projectsatlab/SmartNODE503/README.md

# SmartezNODE503
Smart ezNODE 503 hardware and software platform.

Hardware design assembly into 503 electric plant box based on ESP8266-012F WIFI module. 

Software architecture designed to interface TINKER MODE IoT devices platform.

Coming soon...
