projectsatlab/SmartNODE503/Smart ezNODE 503 TINKER MODE integration.pdf

## Smart ezNODE 503 TINKER MODE integration

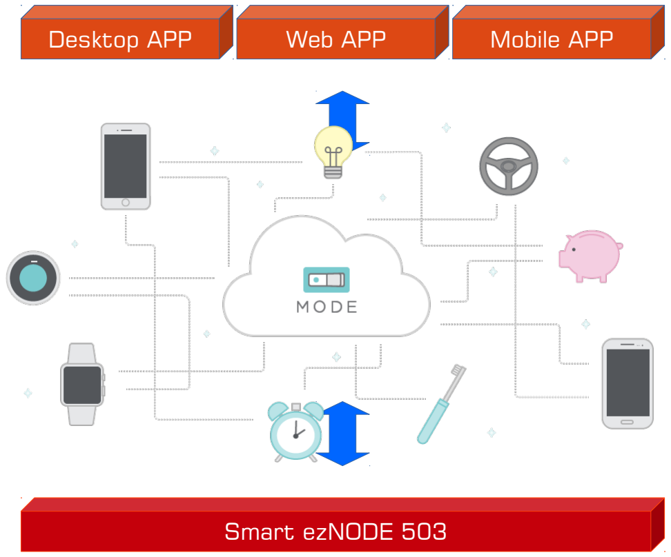
[picture p1: figure]
Smart ezNODE 503; Desktop APP; Web APP; Mobile APP

### www.tinkermode.com

Platform interface 100% open REST API. Code in any language.

WebSocket endpoint:
Allow a user to listen to events;
Allow a device to listen to command.

Android and IOS applications SDK.
