projectsatlab/SmartNODE503/Smart ezNODE 503 M1 (core) schema.pdf

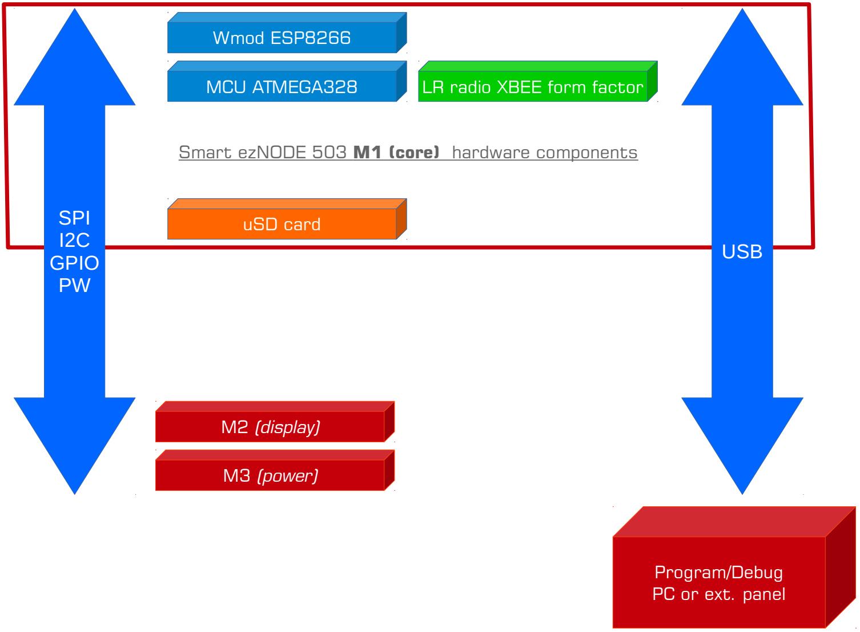
[picture p2: figure]
Program/Debug PC or ext. panel; MCU ATMEGA328; Wmod ESP8266; M2 (display); M3 (power); SPI I2C GPIO PW; uSD card; LR radio XBEE form factor; USB

Smart ezNODE 503 M1 (core) hardware components

## Smart ezNODE 503 M1 (core) schema
