projectsatlab/SmartNODE503/Hardware/Eagle files/20161213_1114_top_gold_with_mask_with_silk.png

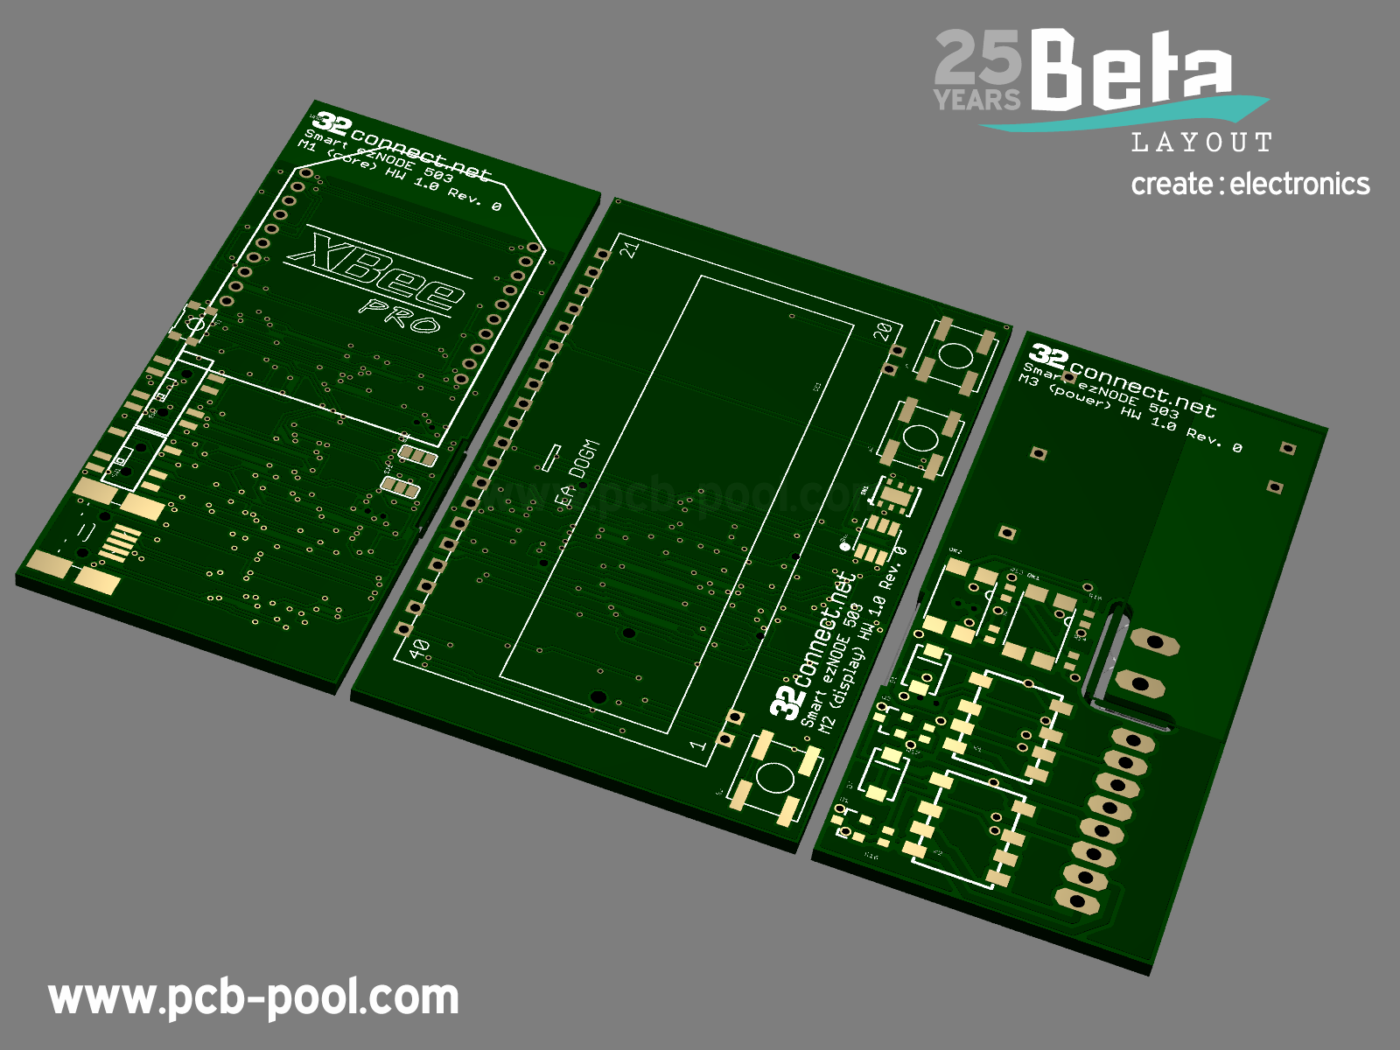
Hardware/Eagle files/20161213_1114_top_gold_with_mask_with_silk.png
