projectsatlab/SmartNODE503/Smart ezNODE 503 architecture schema.pdf

## Project architecture schema

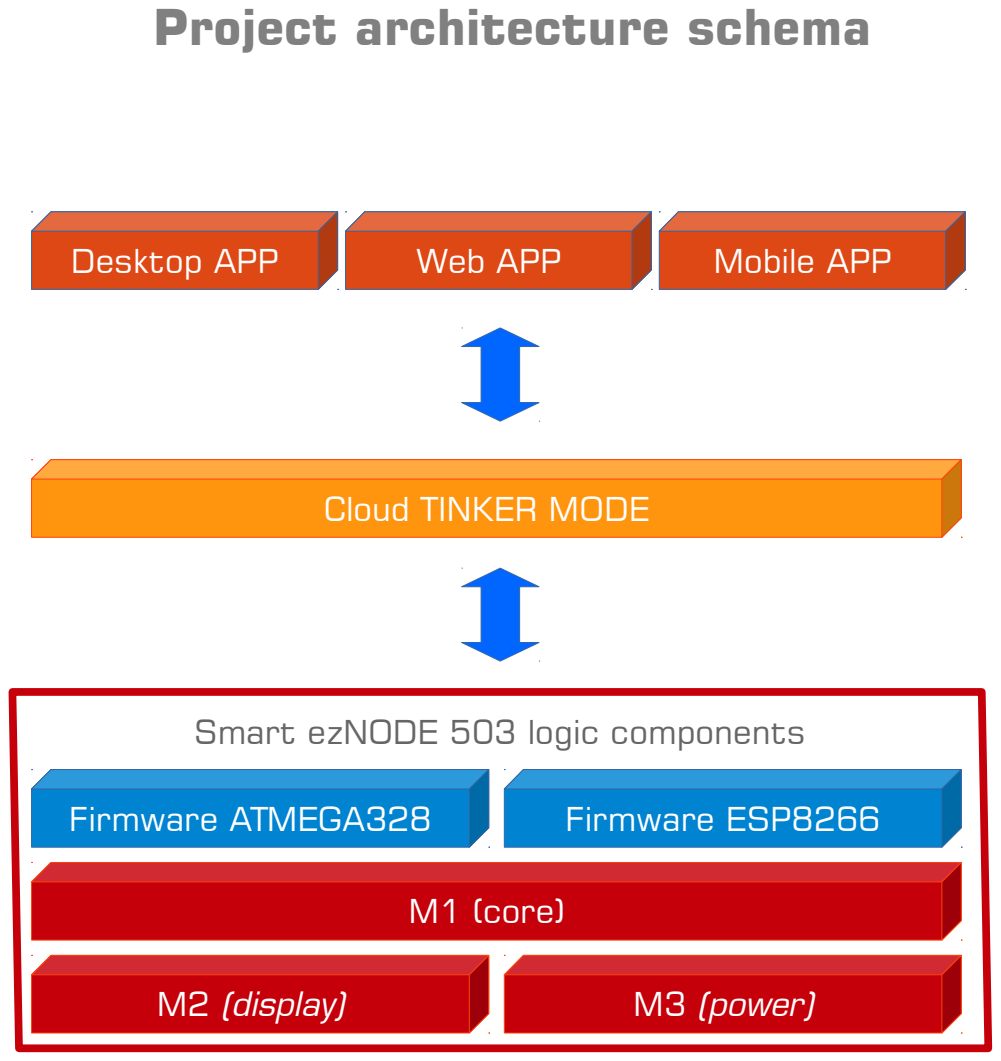
[picture p5: page 1]
M1 (core); Firmware ATMEGA328; Firmware ESP8266; Desktop APP; Web APP; Mobile APP; M2 (display); M3 (power)

Cloud TINKER MODE

Smart ezNODE 503 logic components
