projectsatlab/SmartNODE503/Hardware/Eagle files/Smart ezNODE 503 M1.sch.pdf

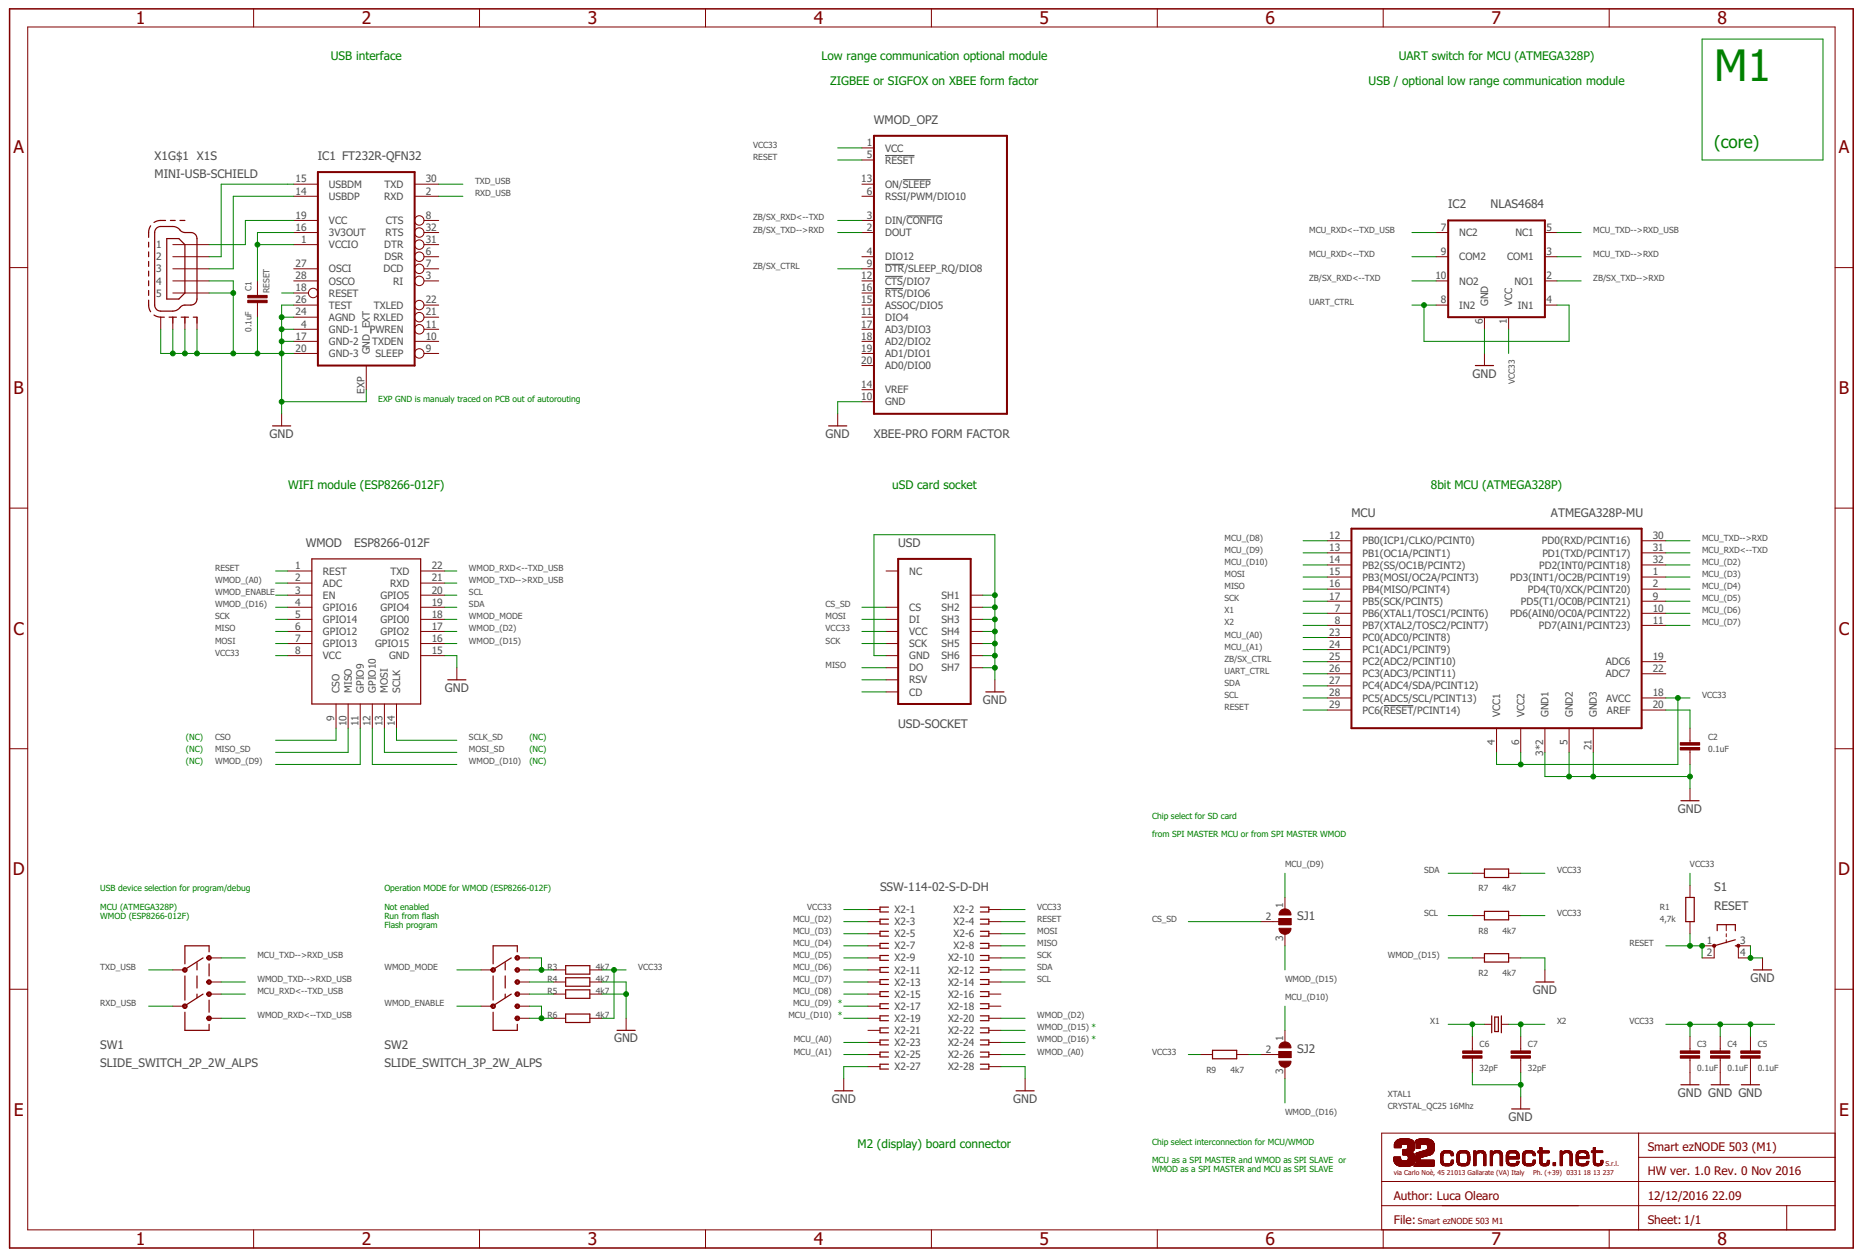
[picture p6: page 1]

USB / optional low range communication module

EXP GND is manualy traced on PCB out of autorouting

Chip select for SD card

from SPI MASTER MCU or from SPI MASTER WMOD

Chip select interconnection for MCU/WMOD MCU as a SPI MASTER and WMOD as SPI SLAVE or WMOD as a SPI MASTER and MCU as SPI SLAVE

HW ver. 1.0 Rev. 0 Nov 2016
