projectsatlab/SmartNODE503/Hardware/Eagle files/Smart ezNODE 503 guide lines.sch.pdf

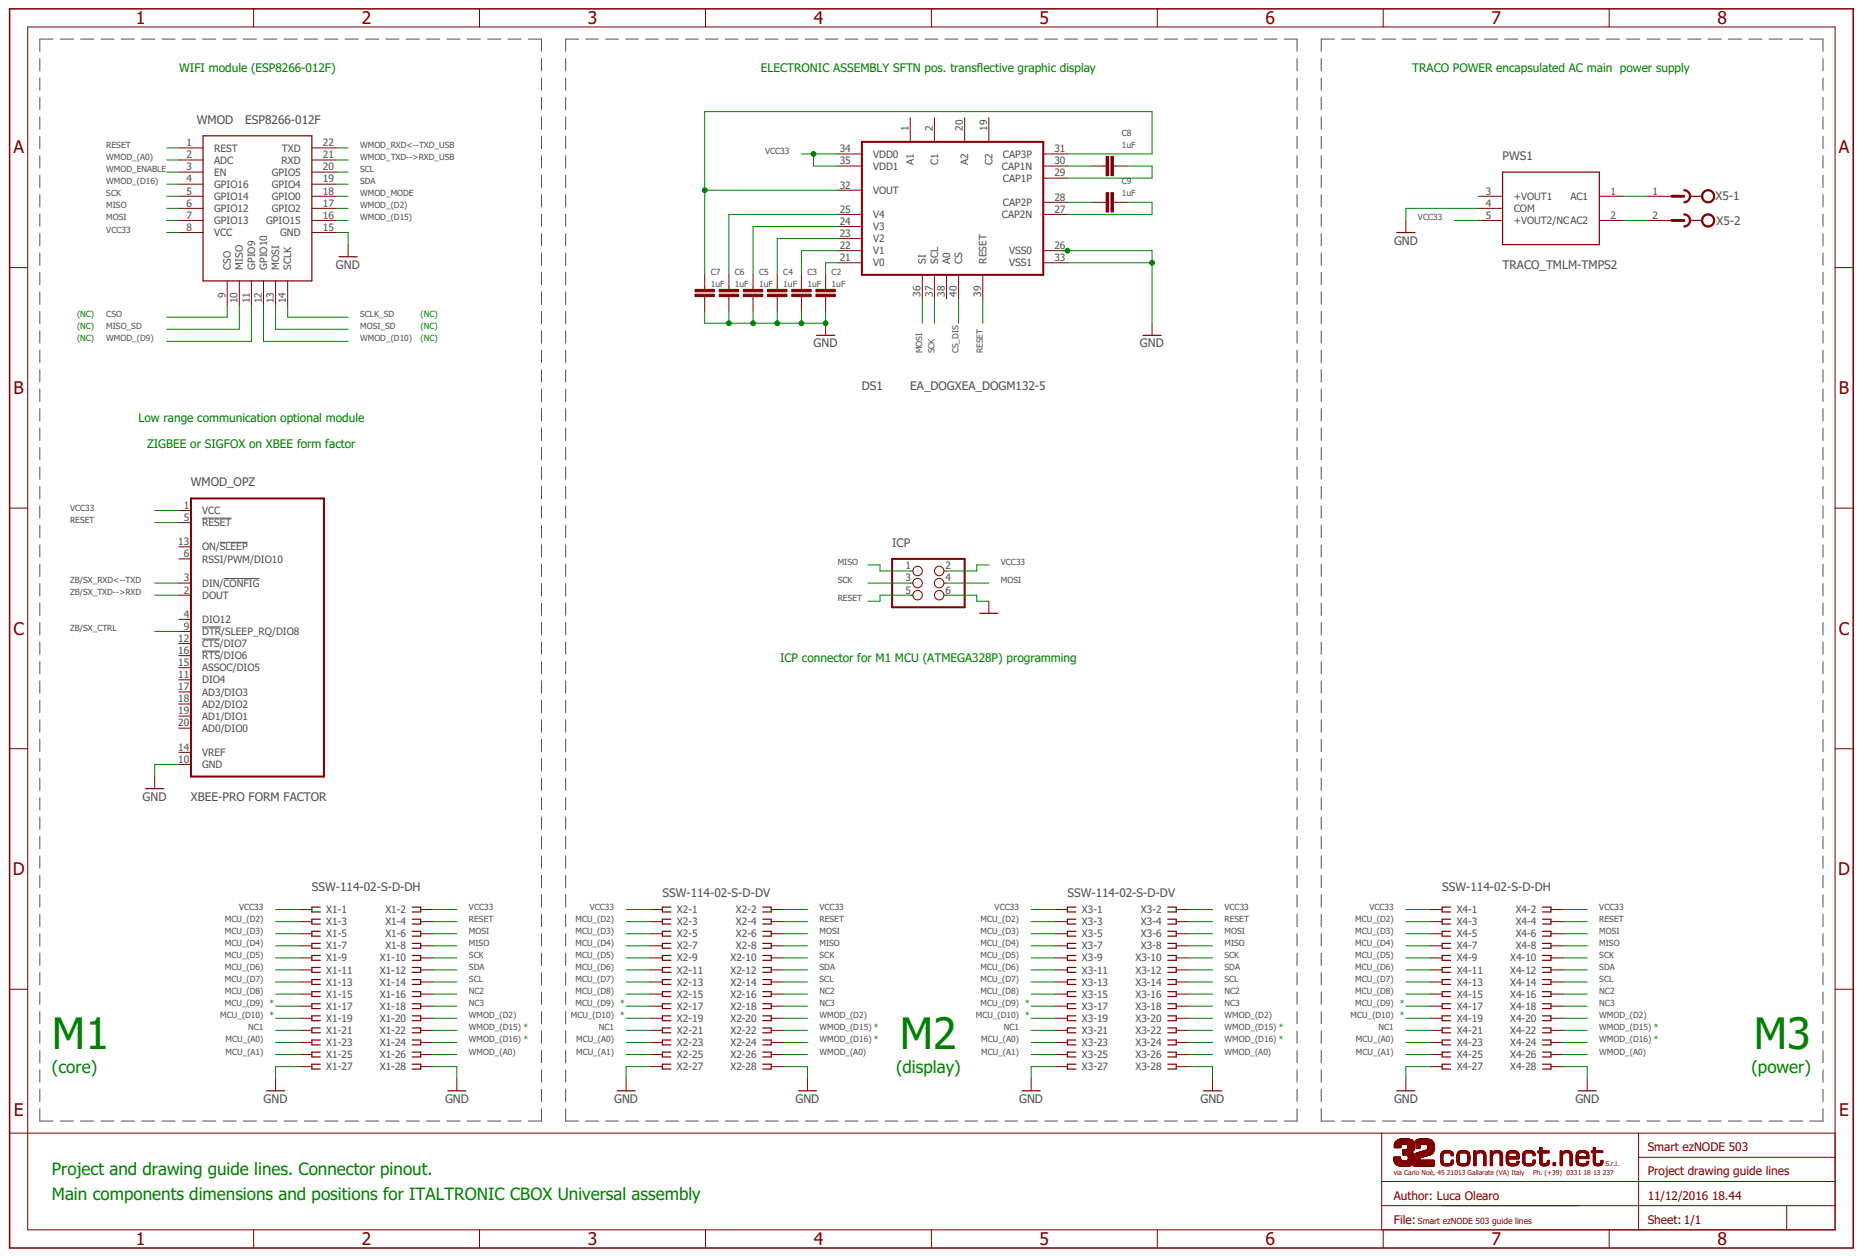
[picture p7: page 1]

Low range communication optional module ZIGBEE or SIGFOX on XBEE form factor

ICP connector for M1 MCU (ATMEGA328P) programming

Project and drawing guide lines. Connector pinout. Main components dimensions and positions for ITALTRONIC CBOX Universal assembly

Project drawing guide lines 11/12/2016 18.44

File: Smart ezNODE 503 guide lines
