projectsatlab/SmartNODE503/Hardware/Eagle files/Smart ezNODE 503 M3.sch.pdf

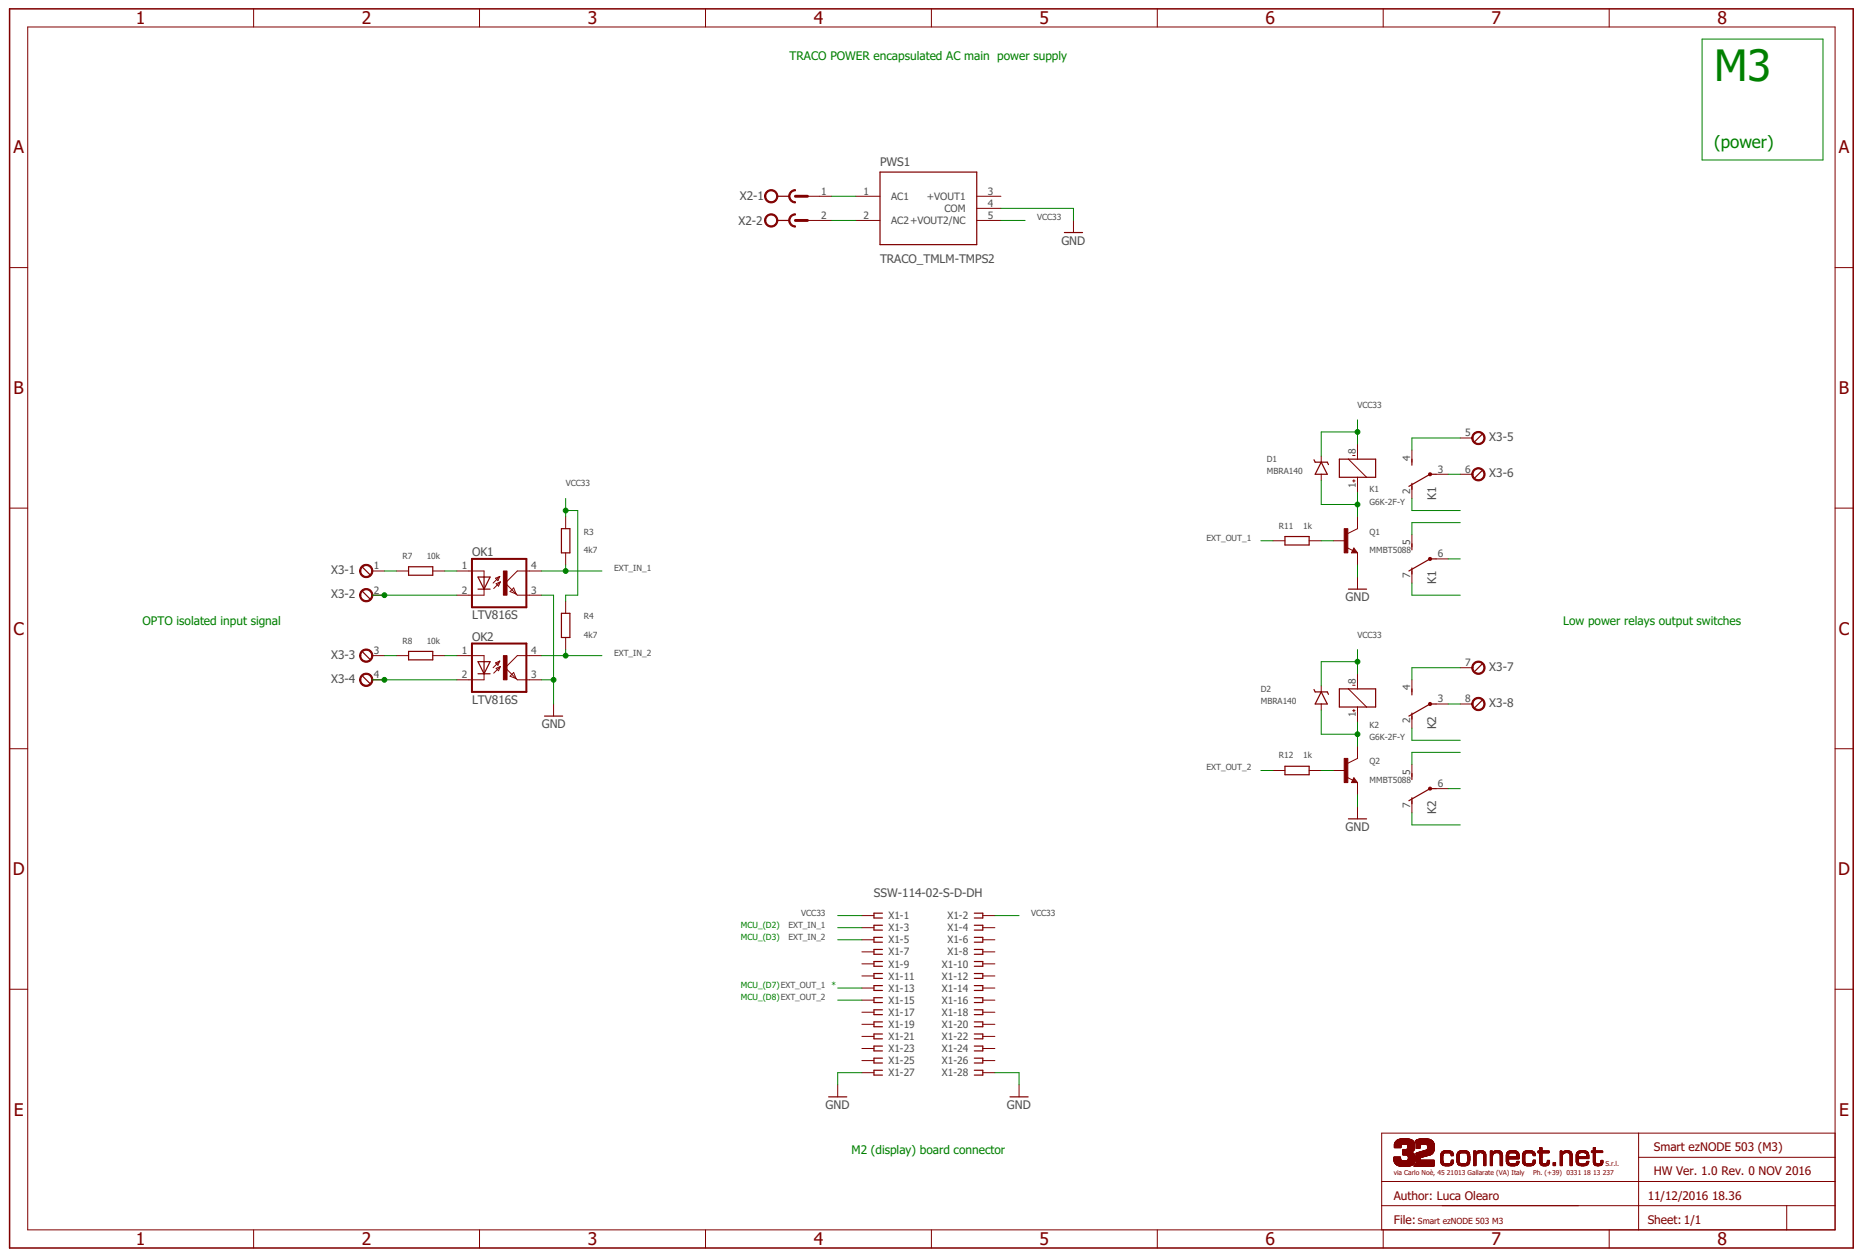
[picture p8: page 1]

TRACO POWER encapsulated AC main power supply

HW Ver. 1.0 Rev. 0 NOV 2016
