projectsatlab/SmartNODE503/Hardware/Eagle files/Smart ezNODE 503 M2.sch.pdf

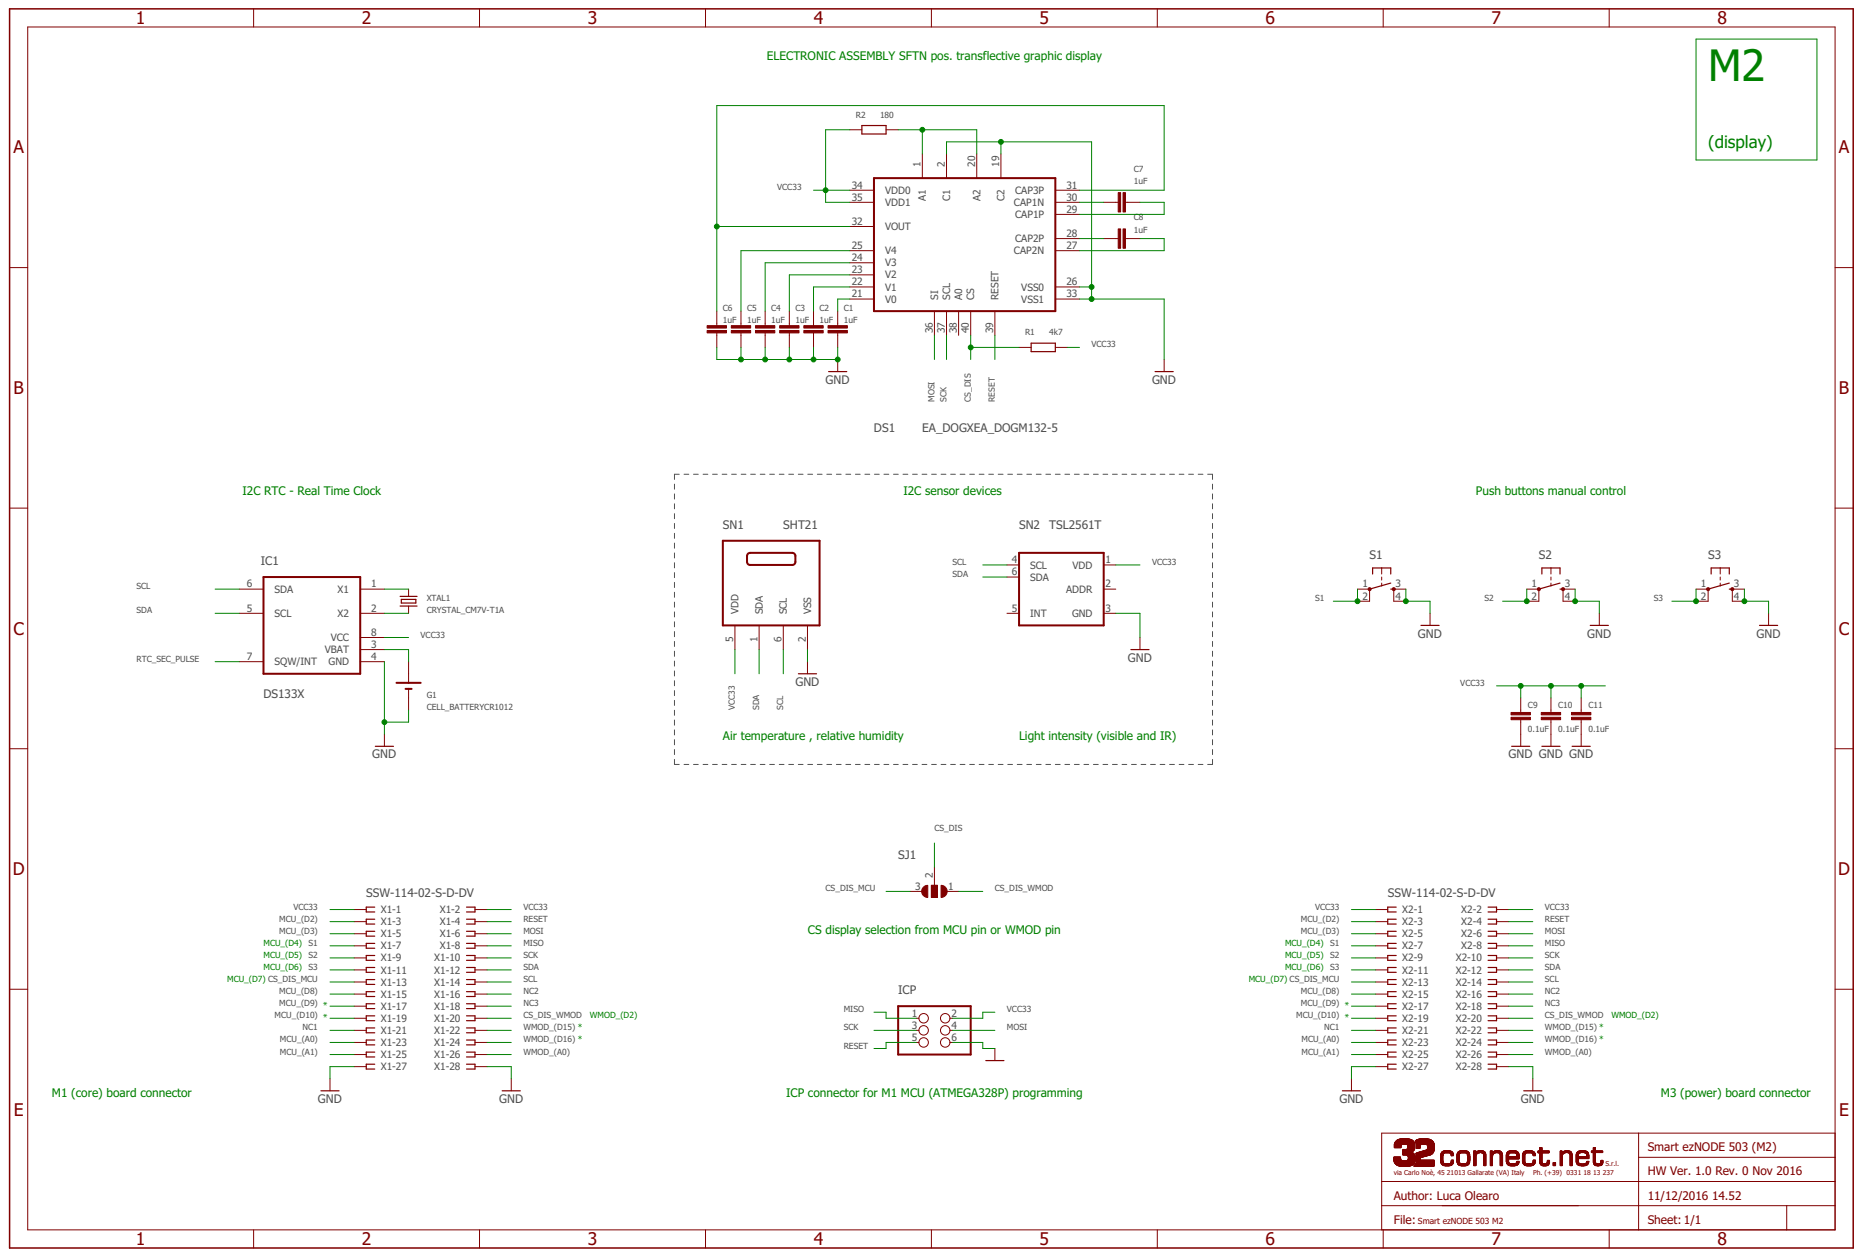
[picture p9: page 1]

ELECTRONIC ASSEMBLY SFTN pos. transflective graphic display

I2C RTC - Real Time Clock

Push buttons manual control

CS display selection from MCU pin or WMOD pin

HW Ver. 1.0 Rev. 0 Nov 2016
