projectsatlab/SmartNODE503/Hardware/Eagle files/BS584d7875344ef_Smart_ezNODE_503_M1-M2-M3_PCB_assembly_20161213121305.pdf

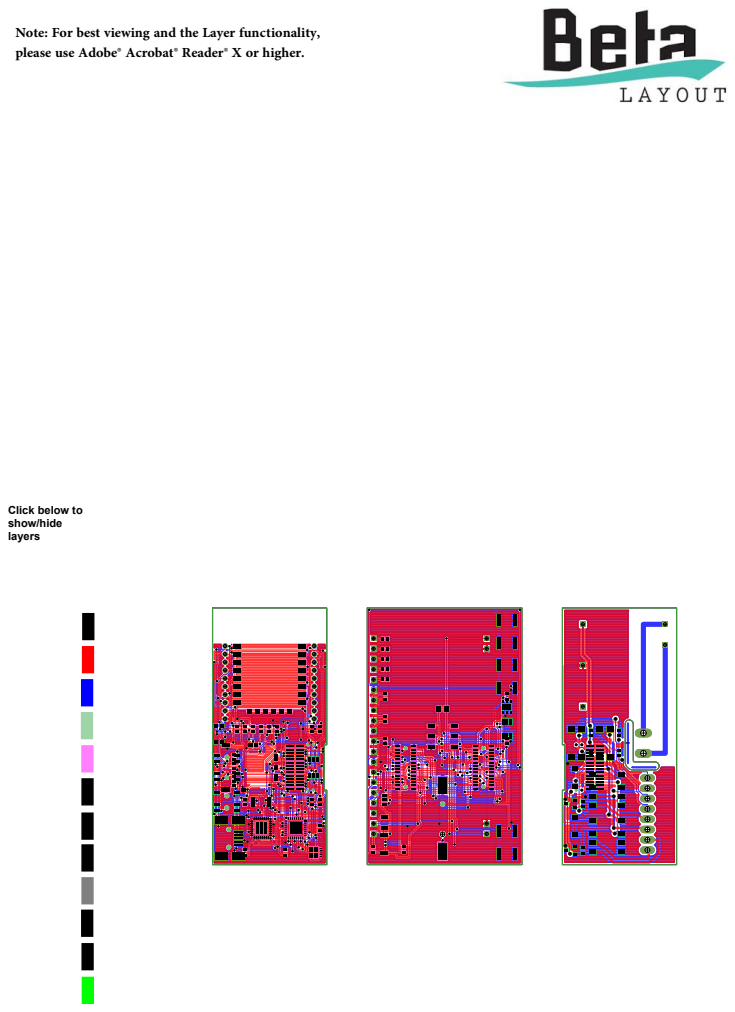
[picture p10: page 1]

Note: For best viewing and the Layer functionality,
please use Adobe® Acrobat® Reader® X or higher.
