projectsatlab/SmartNODE503/Hardware/Eagle files/Smart ezNODE 503 M1-M2-M3 PCB assembly.brd.pdf

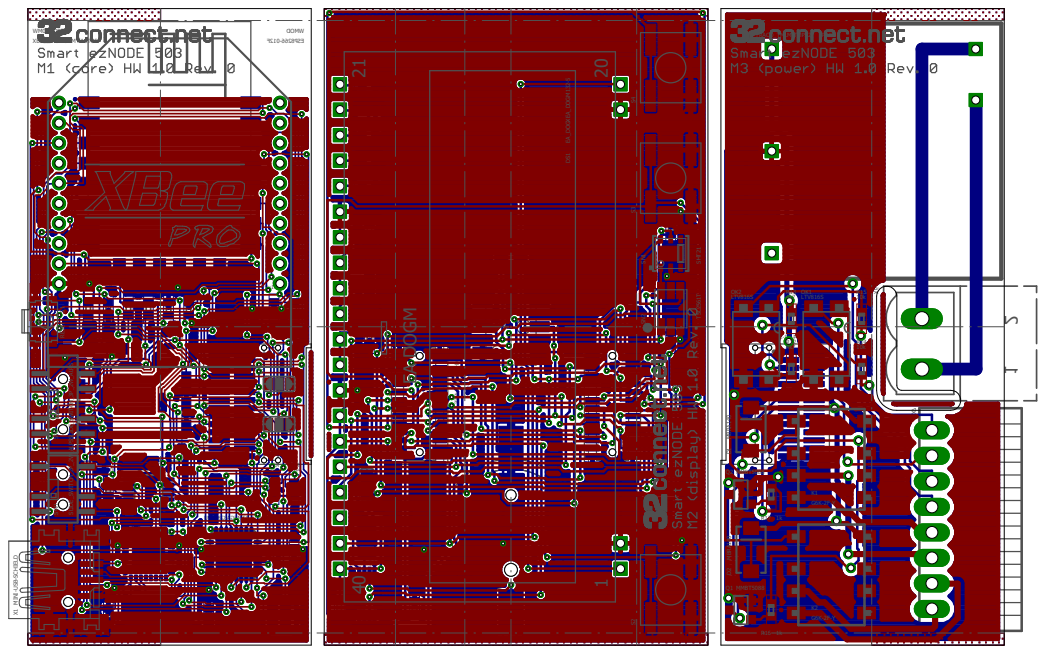
[picture p11: page 1]

Fu1. 0 F210- 6628PSE 23NF Q- R232TF UM- P823AGE MTA 4864SAL N 7k4 7k4 7k4 7k4 zh M61 52CQ_LATSYRC k7, 4 Fu1. 0 Fu1. 0 Fu1. 0 Fu1. 0 TEKCOS- DSU 7k4 7k4 7k4 HD- D- S- 20- 411- WSS7k432pF 32pF Fu1 Fu1 Fu1 Fu1 Fu1 Fu1 Fu1 Fu1 2101RCYRETTAB_LLEC CRYSTAL_CM7V-T1A SSW-114-02-S-D-DV DS133X SSW-114-02-S-D-DV 7k4 081 Fu1. 0 Fu1. 0 Fu1. 0 HD- D- S- 20- 411- WSS 1C 1CI UC M 2CI 6R 3R 5R 4R 1LATX 1R 2C 3C 4C 5C DSU 2R 8R 7R 2X 9RC6 C7 8C9C 01C 11C 21C 31C 41C 51C 1G XTAL2 X3 IC3 X4 ICP 01R SJ3 11R 61C 71C 81C 5X X6 X7 DOMW 2 1 1 2021 40 EA DOGM X1 SW1 SW2 WMOD_OPZS1 SJ1 SJ2 DS1 S2 S3 S4 SN1 SN2 OK2 OK1 R12 R13 R14 R15 K1 D1 Q1 R16 K2 D2 Q2 R17 PWS1 MINI-USB-SCHIELD SLIDE_SWITCH_2P_2W_ALPS LIDE_SWITCH_3P_2W_ALPS XBEE-PRO FORM FACTOR RESET EA_DOGXEA_DOGM132-5 SHT21 TSL2561TLTV816S LTV816S 4k7 4k7 10k 10k G6K-2F-Y MBRA140 MMBT5088 1k G6K-2F-Y MBRA140 MMBT5088 1k TRACO_TMLM-TMPS2
