projectsatlab/SmartNODE503/Hardware/Eagle files/Smart ezNODE 503 guide lines.brd.pdf

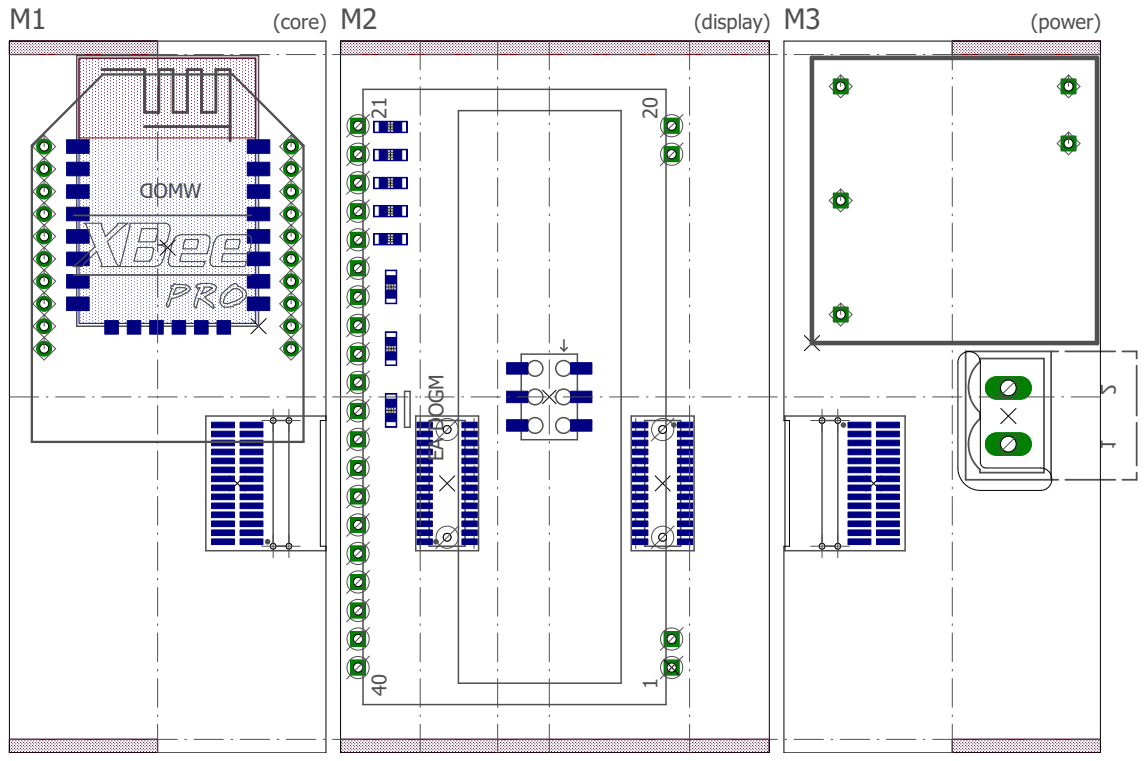
[picture p12: page 1]
