projectsatlab/SmartNODE503/Hardware/Techinical documents/ITALTRONIC cbox (1).pdf

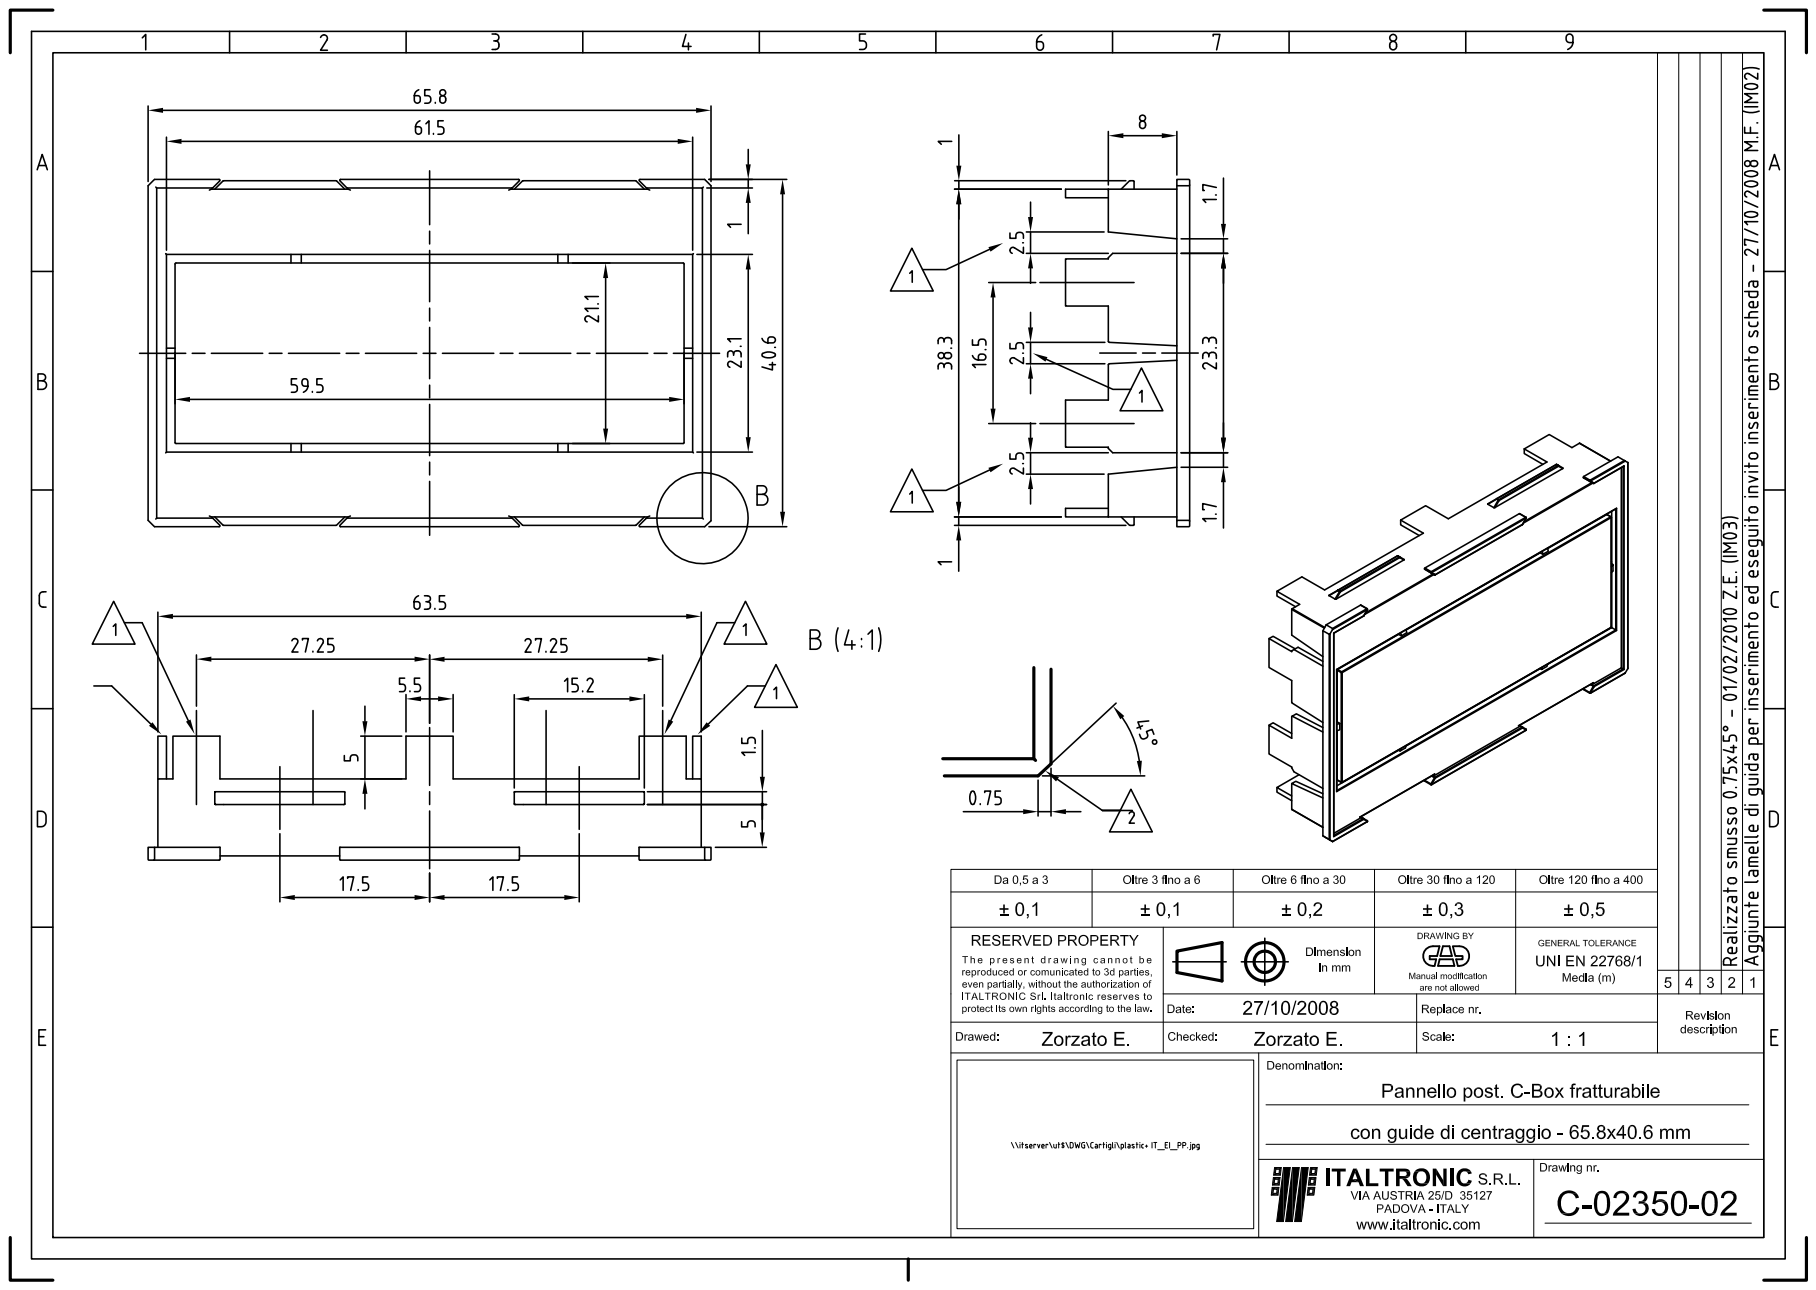
[picture p13: page 1]
