projectsatlab/SmartNODE503/Hardware/Eagle files/Smart ezNODE 503 M3.brd

## EAGLE design Hardware/Eagle files/Smart ezNODE 503 M3.brd (2016-12-13)

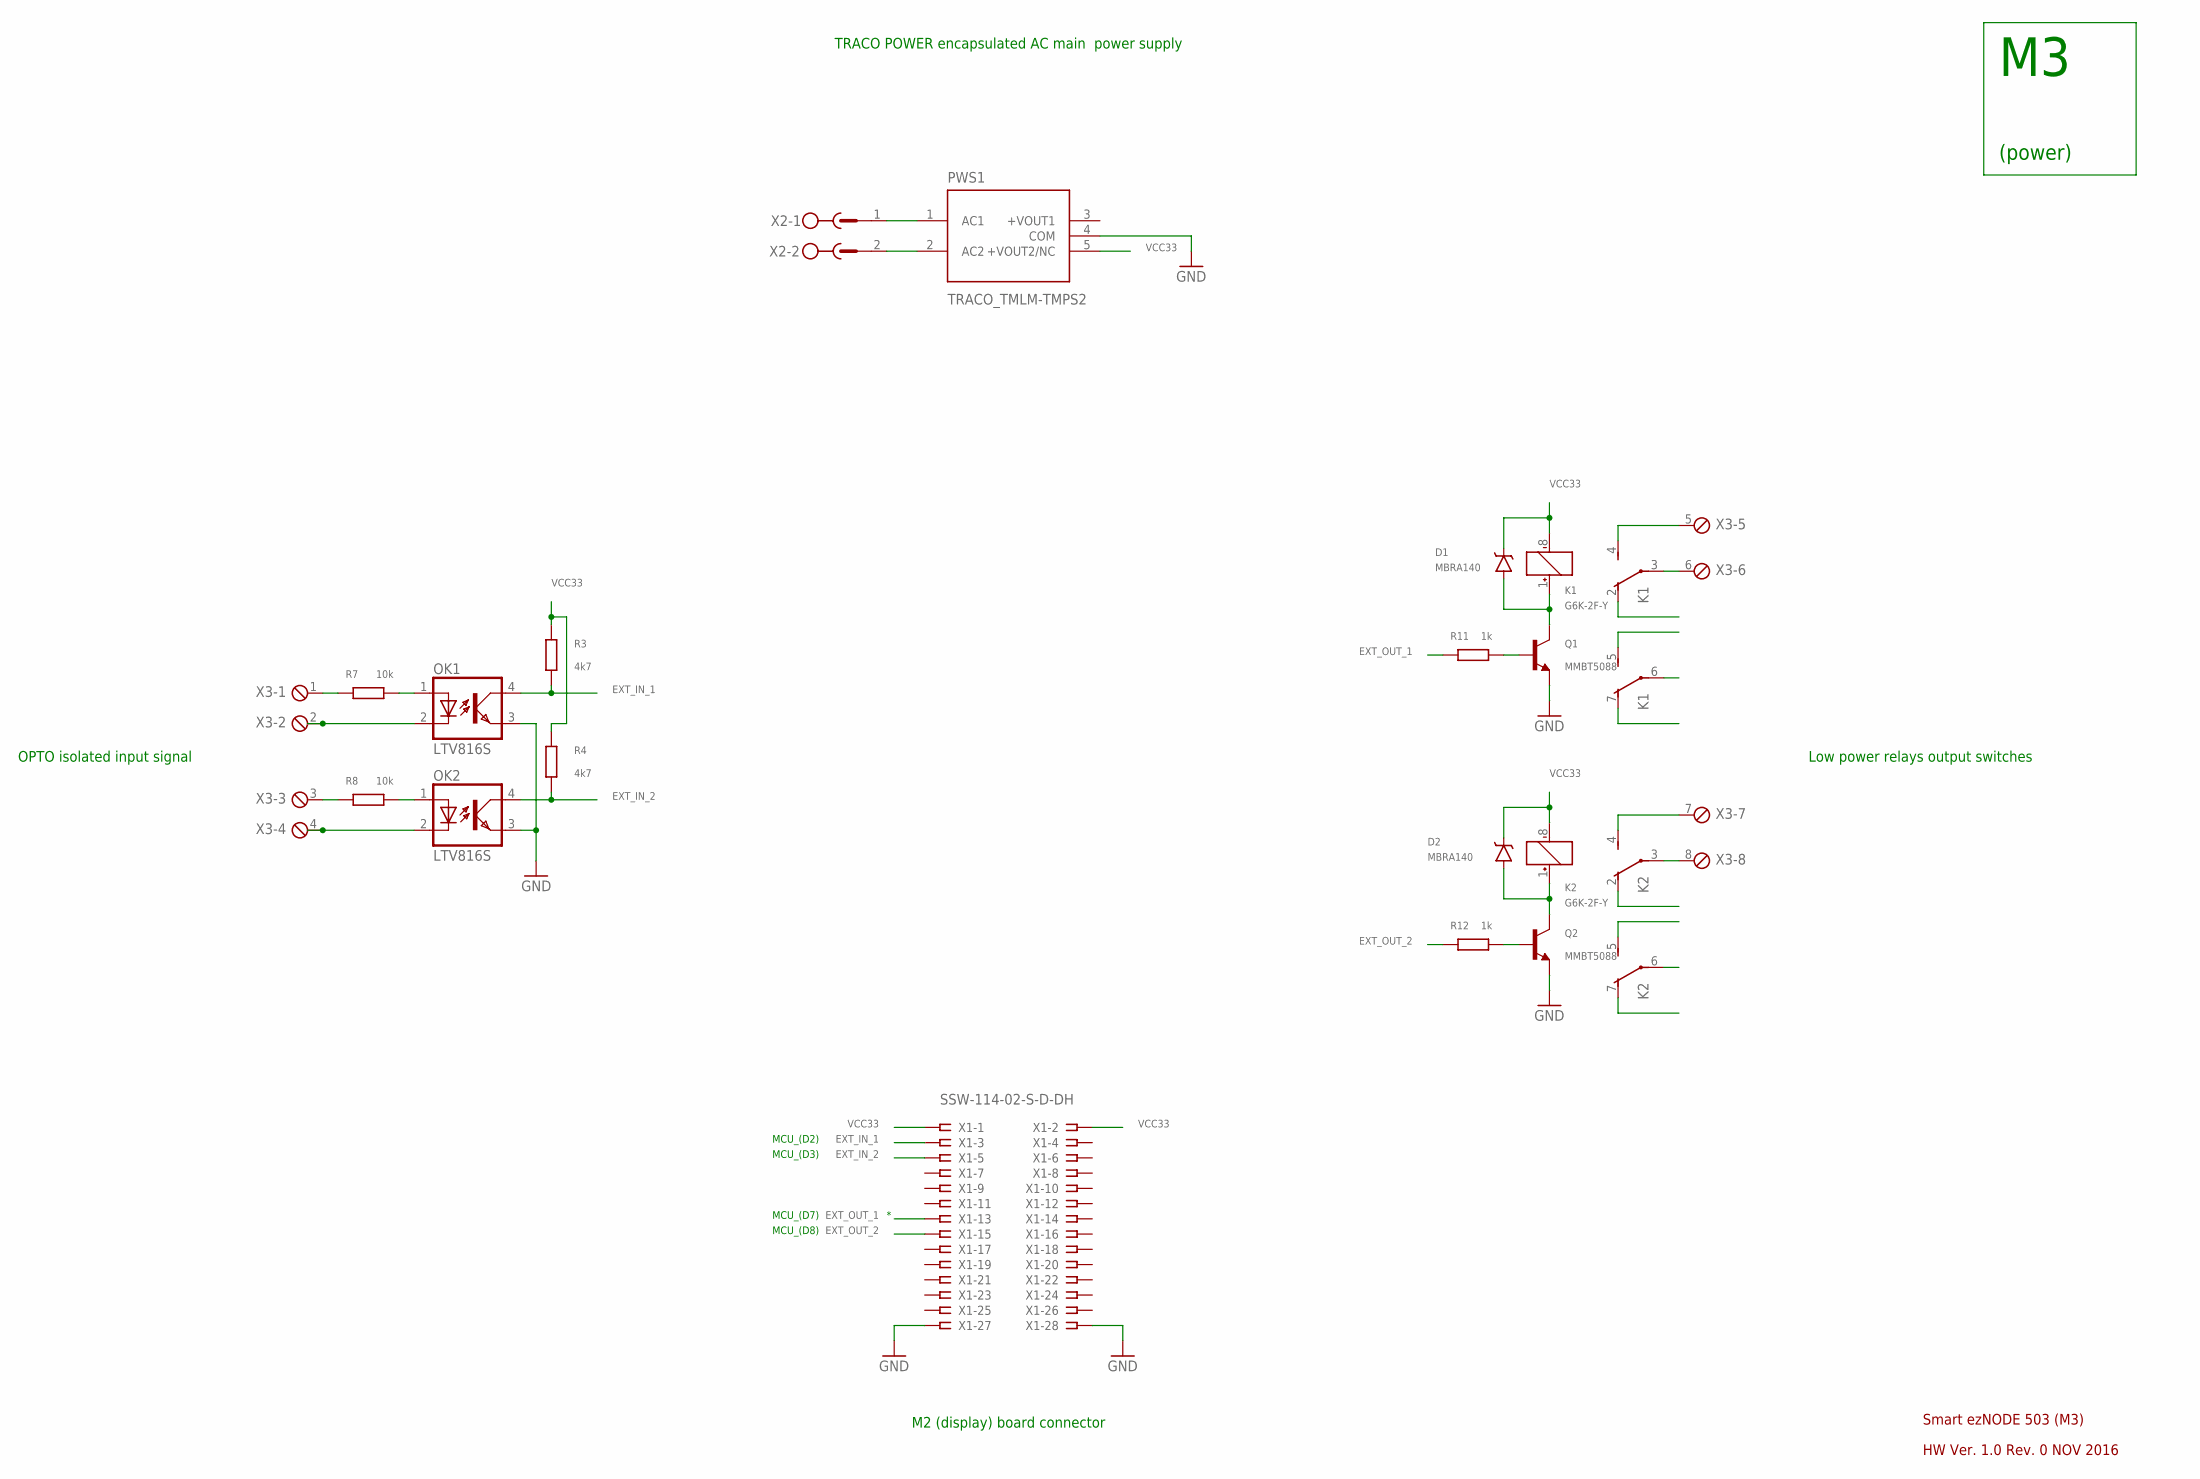
[picture p14: schematic Smart ezNODE 503 M3.sch]

Parts:
D1, D2: MBRA140; SMA-DIODE
K1, K2: G6K-2F-Y
OK1, OK2: LTV816S; SMD4
PWS1: TRACO_TMLM-TMPS2; TRACO_TMPS03XXX
Q1, Q2: MMBT5088; SOT23-3
R3, R4: 4k7; R0402
R7, R8: 10k; R0402
R11, R12: 1k; R0402
X1: SSW-114-02-S-D-DH; FTE-114-XX-G-DH
X2: MSTBV2
X3: MPT8; 8POL254

Connections:
EXT_IN_1: OK1.4 (COL), R3.1, X1.3
EXT_IN_2: OK2.4 (COL), R4.1, X1.5
EXT_OUT_1: R11.1, X1.13
EXT_OUT_2: R12.1, X1.15
GND: OK1.3 (EMIT), OK2.3 (EMIT), PWS1.4 (COM), Q1.2 (E), Q2.2 (E), X1.27, X1.28
unnamed: PWS1.1 (AC1), X2.1
unnamed: PWS1.2 (AC2), X2.2
unnamed: R7.1, X3.1
unnamed: R8.1, X3.3
unnamed: K1.4 (S), X3.5
unnamed: OK1.2 (C), X3.2
unnamed: OK1.1 (A), R7.2
unnamed: OK2.1 (A), R8.2
unnamed: OK2.2 (C), X3.4
unnamed: K1.3, X3.6
unnamed: D1.A, K1.1 (+), Q1.3 (C)
unnamed: D2.A, K2.1 (+), Q2.3 (C)
unnamed: Q1.1 (B), R11.2
unnamed: Q2.1 (B), R12.2
unnamed: K2.4 (S), X3.7
unnamed: K2.3, X3.8
VCC33: D1.C, D2.C, K1.8 (-), K2.8 (-), PWS1.5 (+VOUT2/NC), R3.2, R4.2, X1.1, X1.2

Notes on the sheet:
(power)
Smart ezNODE 503 (M3)
HW Ver. 1.0 Rev. 0 NOV 2016
TRACO POWER encapsulated AC main power supply
MCU_(D2)
MCU_(D3)
MCU_(D7)
MCU_(D8)
OPTO isolated input signal
Low power relays output switches
M2 (display) board connector

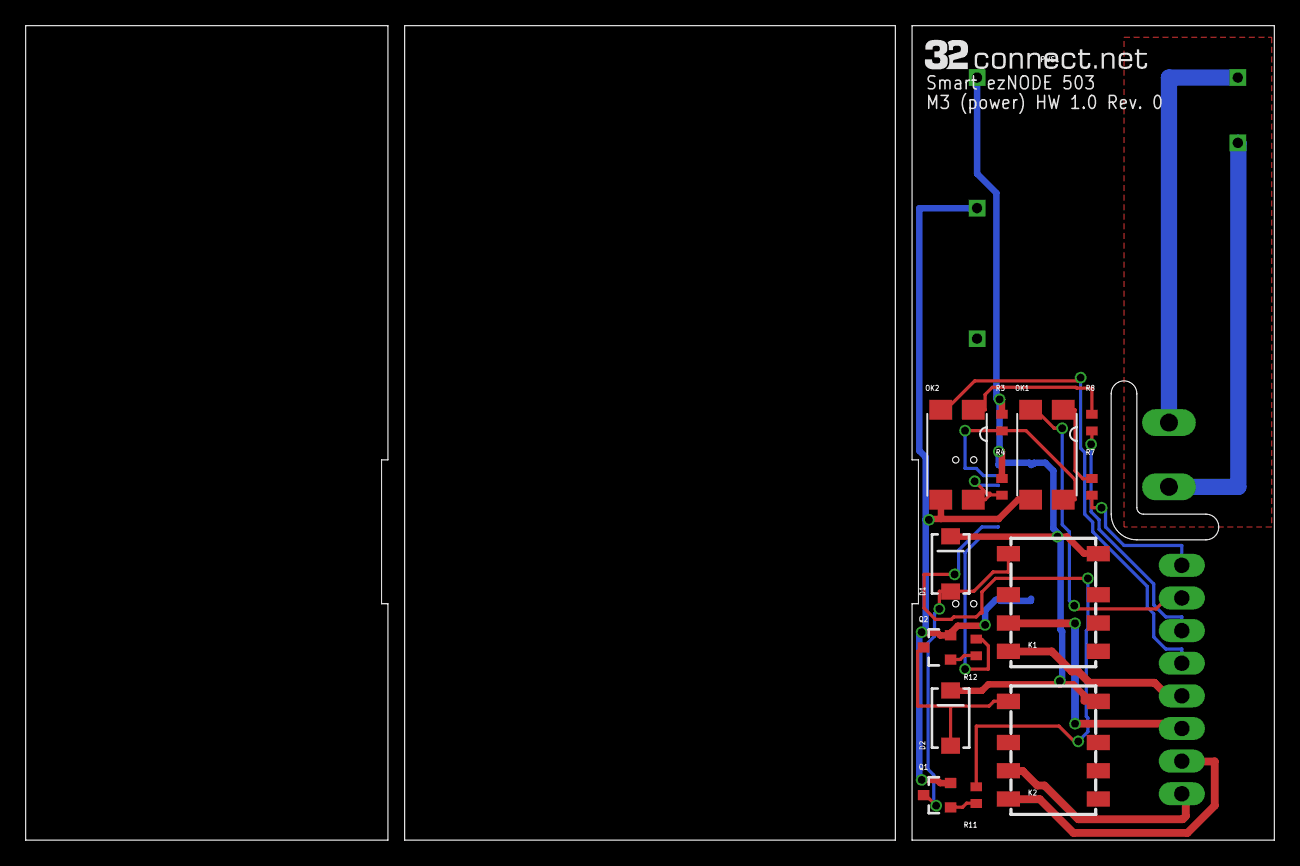
[picture p15: board Smart ezNODE 503 M3.brd from above]

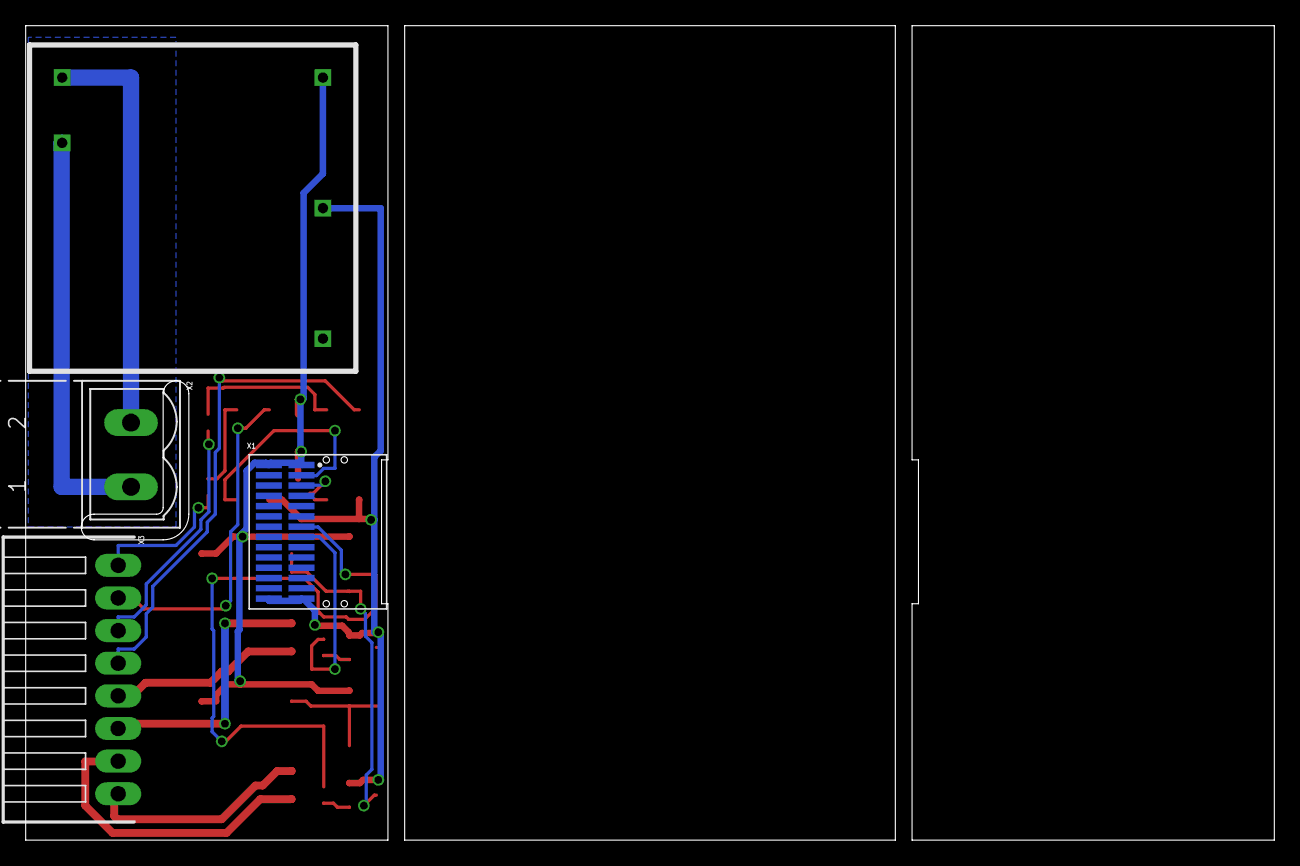
[picture p16: board Smart ezNODE 503 M3.brd from below]

Board: 2 copper layers, 97.2 x 63.4 mm, 18 parts (4 on the bottom side), 22 nets.
