projectsatlab/SmartNODE503/Hardware/Eagle files/Smart ezNODE 503 M2.brd

## EAGLE design Hardware/Eagle files/Smart ezNODE 503 M2.brd (2016-12-12)

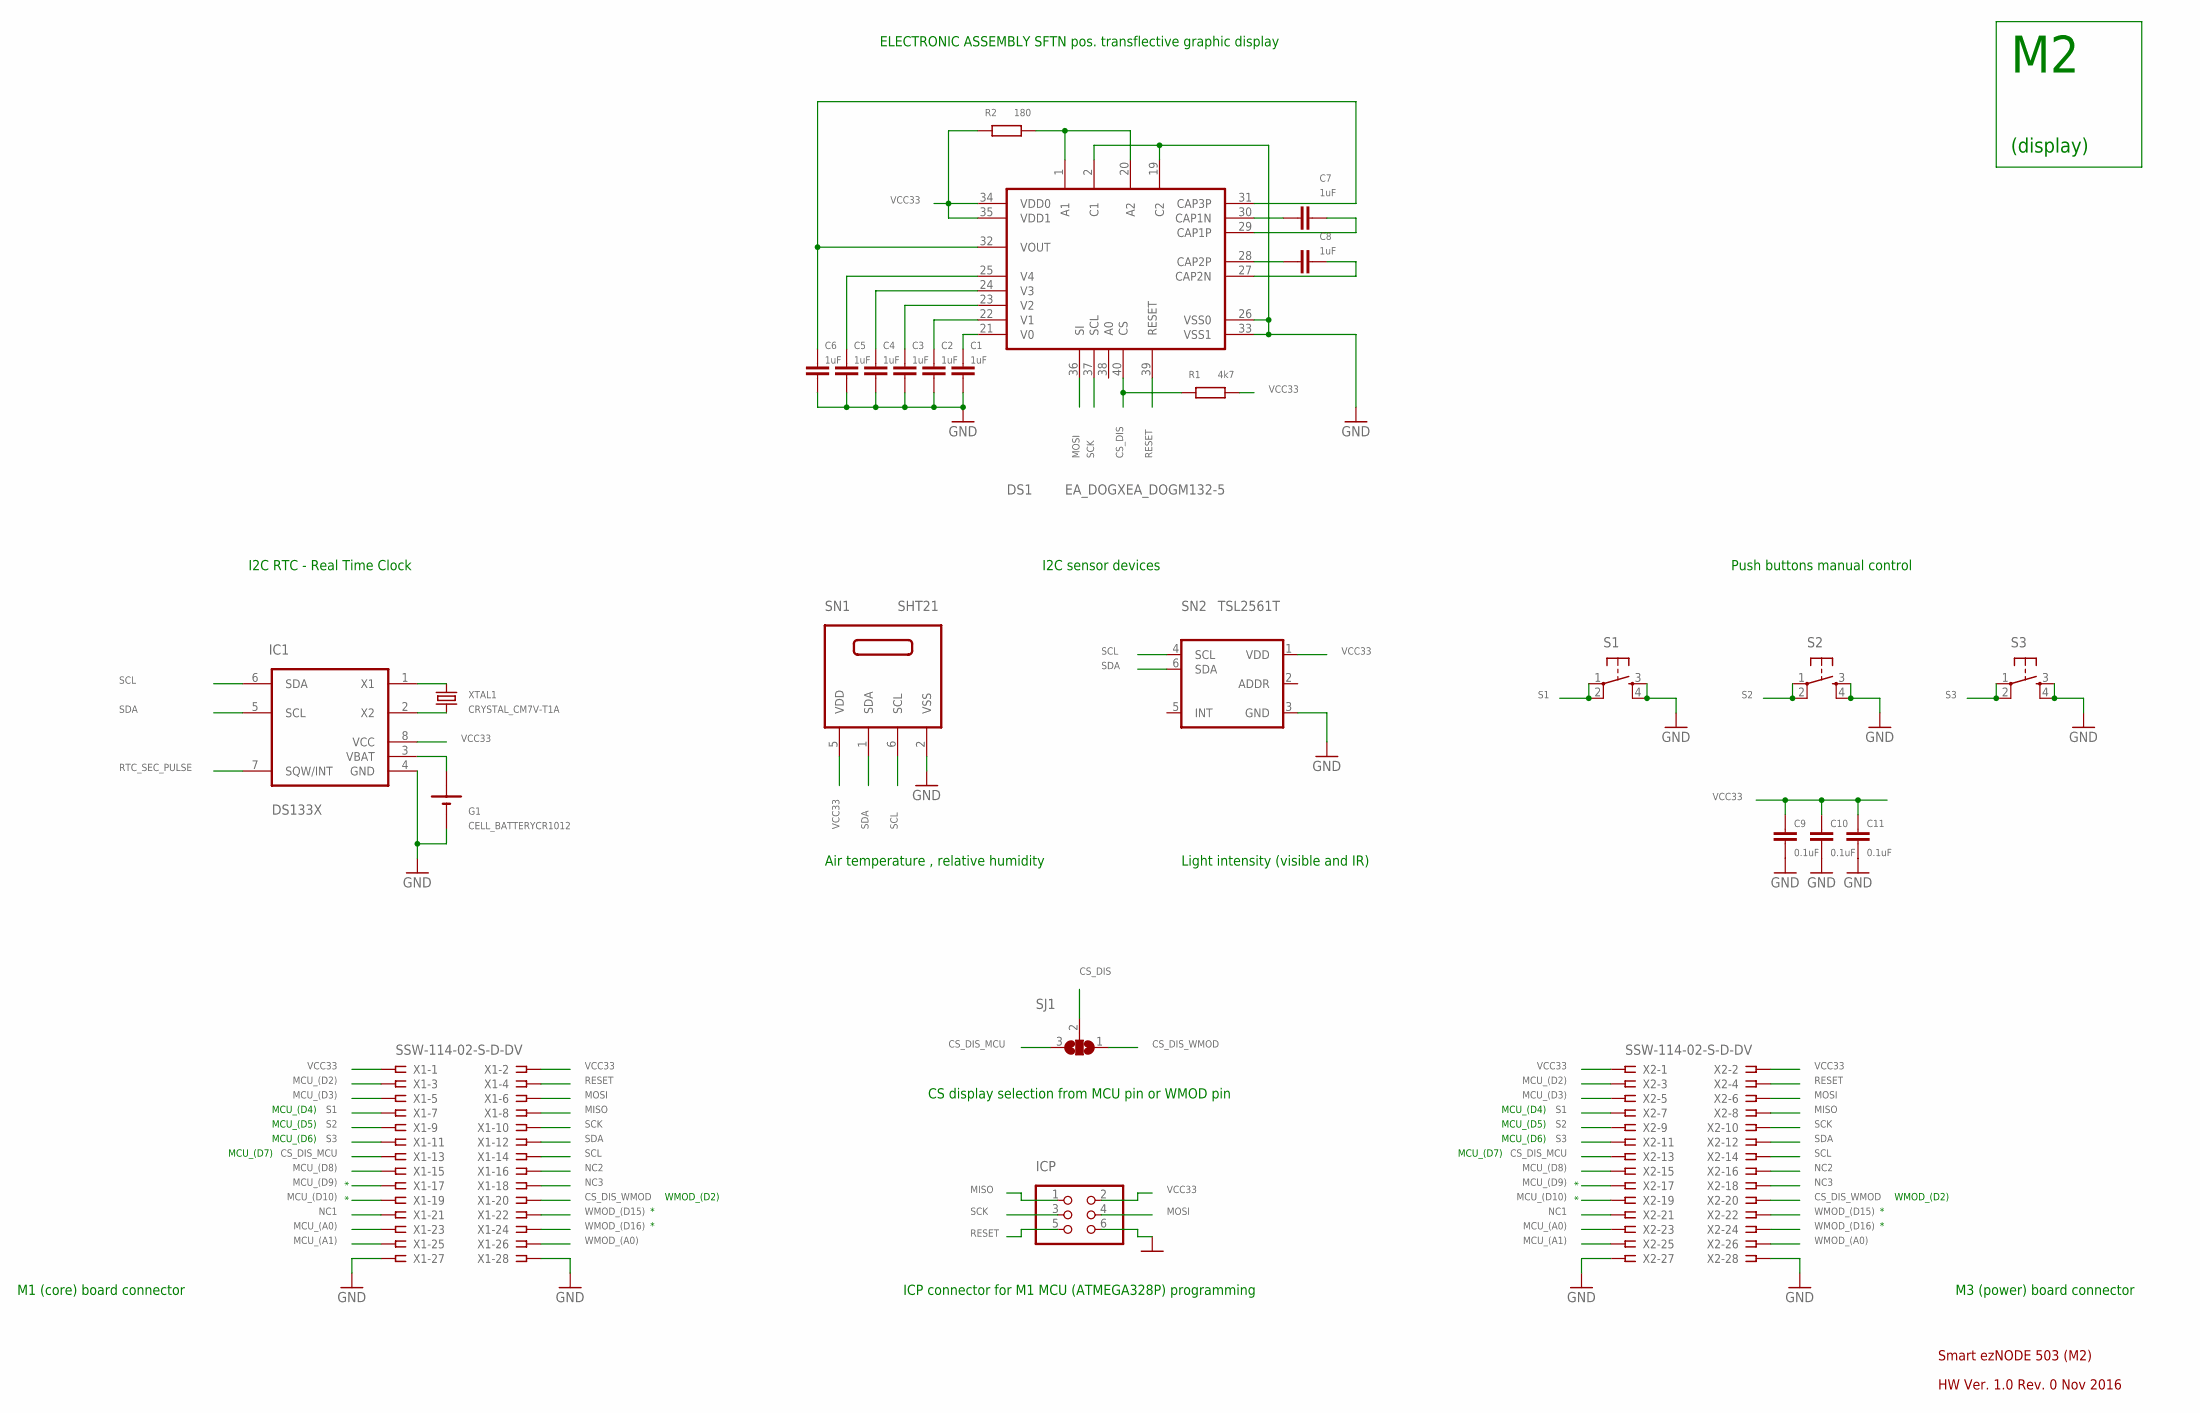
[picture p17: schematic Smart ezNODE 503 M2.sch]

Parts:
C1, C2, C3, C4, C5, C6, C7, C8: 1uF; C0402
C9, C10, C11: 0.1uF; C0402
DS1: EA_DOGXEA_DOGM132-5; EA_DOGM
G1: CELL_BATTERYCR1012; 12MM_SMD_COIN_CELL_BATTERY_HOLDER
IC1: DS133X; MICRO08
ICP: PINHD-2X3/SMD; 2X3_SMD
R1: 4k7; R0402
R2: 180; R0805
S1, S2, S3: TAC_SWITCH3; C&KKSCX_BEND
SJ1: SJ2W; SJ_2
SN1: SHT21; DFN6/SHT
SN2: TSL2561T; TMB-6
X1, X2: SSW-114-02-S-D-DV; CLE-114-01-X-DV-A
XTAL1: CRYSTAL_CM7V-T1A

Connections:
CS_DIS: DS1.40 (CS), R1.1, SJ1.2
CS_DIS_MCU: SJ1.3, X1.13, X2.13
CS_DIS_WMOD: SJ1.1, X1.20, X2.20
GND: C1.2, C2.2, C3.2, C4.2, C5.2, C6.2, C9.2, C10.2, C11.2, DS1.2 (C1), DS1.19 (C2), DS1.26 (VSS0), DS1.33 (VSS1), G1.P$2 (-), IC1.4 (GND), ICP.6, S1.3, S1.4, S2.3, S2.4, S3.3, S3.4, SN1.2 (VSS), SN2.3 (GND), X1.27, X1.28, X2.27, X2.28
MCU_(A0): X1.23, X2.23
MCU_(A1): X1.25, X2.25
MCU_(D2): X1.3, X2.3
MCU_(D3): X1.5, X2.5
MCU_(D8): X1.15, X2.15
MCU_(D9): X1.17, X2.17
MCU_(D10): X1.19, X2.19
MISO: ICP.1, X1.8, X2.8
MOSI: DS1.36 (SI), ICP.4, X1.6, X2.6
unnamed: IC1.1 (X1), XTAL1.P$2 (2)
unnamed: IC1.2 (X2), XTAL1.P$1 (1)
unnamed: DS1.1 (A1), DS1.20 (A2), R2.1
unnamed: C1.1, DS1.21 (V0)
unnamed: C7.1, DS1.30 (CAP1N)
unnamed: C2.1, DS1.22 (V1)
unnamed: C3.1, DS1.23 (V2)
unnamed: C4.1, DS1.24 (V3)
unnamed: C5.1, DS1.25 (V4)
unnamed: C6.1, DS1.31 (CAP3P), DS1.32 (VOUT)
unnamed: C7.2, DS1.29 (CAP1P)
unnamed: C8.1, DS1.28 (CAP2P)
unnamed: C8.2, DS1.27 (CAP2N)
unnamed: G1.P$1 (+), IC1.3 (VBAT)
NC1: X1.21, X2.21
NC2: X1.16, X2.16
NC3: X1.18, X2.18
RESET: DS1.39 (RESET), ICP.5, X1.4, X2.4
RTC_SEC_PULSE: IC1.7 (SQW/INT)
S1: S1.1, S1.2, X1.7, X2.7
S2: S2.1, S2.2, X1.9, X2.9
S3: S3.1, S3.2, X1.11, X2.11
SCK: DS1.37 (SCL), ICP.3, X1.10, X2.10
SCL: IC1.5 (SCL), SN1.6 (SCL), SN2.4 (SCL), X1.14, X2.14
SDA: IC1.6 (SDA), SN1.1 (SDA), SN2.6 (SDA), X1.12, X2.12
VCC33: C9.1, C10.1, C11.1, DS1.34 (VDD0), DS1.35 (VDD1), IC1.8 (VCC), ICP.2, R1.2, R2.2, SN1.5 (VDD), SN2.1 (VDD), X1.1, X1.2, X2.1, X2.2
WMOD_(A0): X1.26, X2.26
WMOD_(D15): X1.22, X2.22
WMOD_(D16): X1.24, X2.24

Notes on the sheet:
(display)
Smart ezNODE 503 (M2)
HW Ver. 1.0 Rev. 0 Nov 2016
WMOD_(D2)
MCU_(D4)
MCU_(D5)
MCU_(D6)
ELECTRONIC ASSEMBLY SFTN pos. transflective graphic display
I2C sensor devices
Air temperature , relative humidity
Light intensity (visible and IR)
I2C RTC - Real Time Clock
ICP connector for M1 MCU (ATMEGA328P) programming
M1 (core) board connector
M3 (power) board connector
Push buttons manual control
MCU_(D7)
CS display selection from MCU pin or WMOD pin

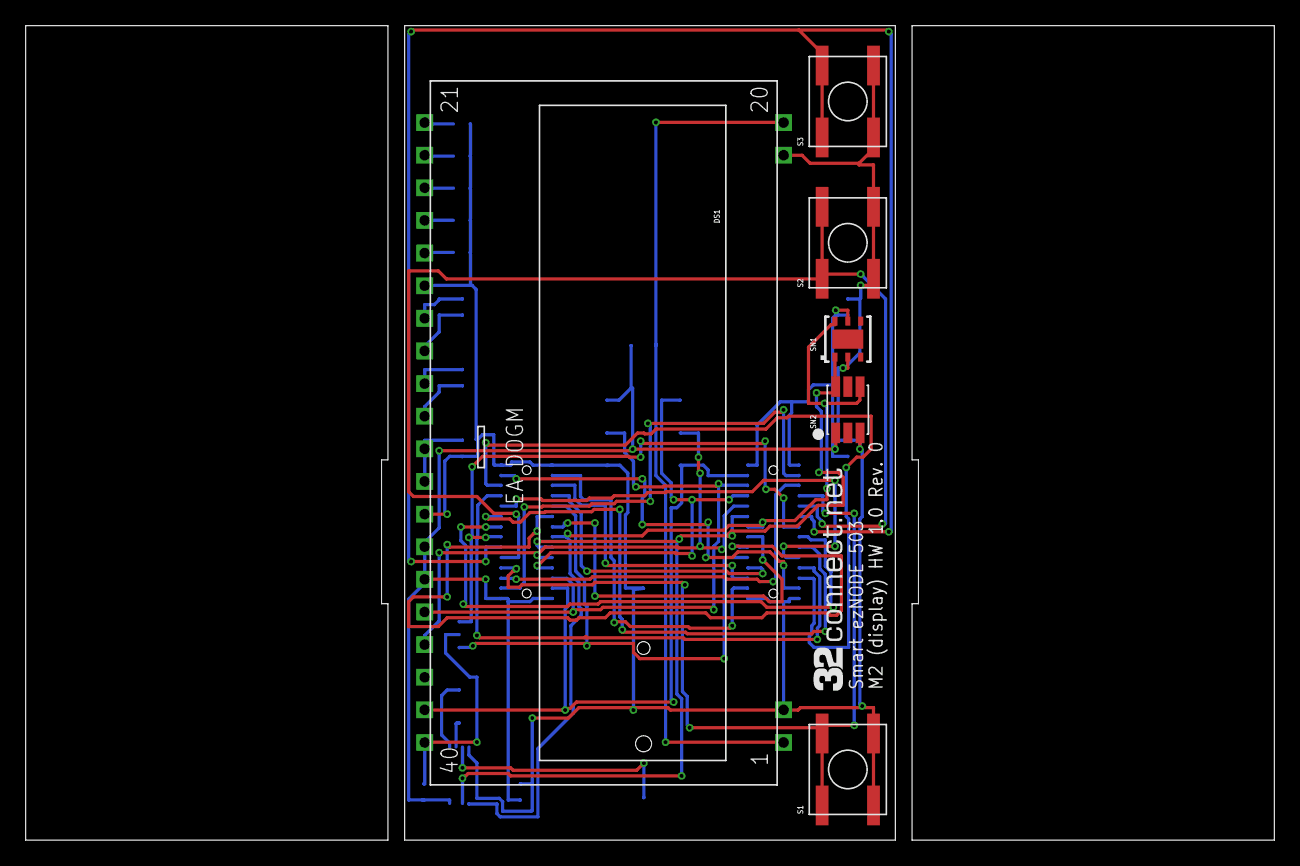
[picture p18: board Smart ezNODE 503 M2.brd from above]

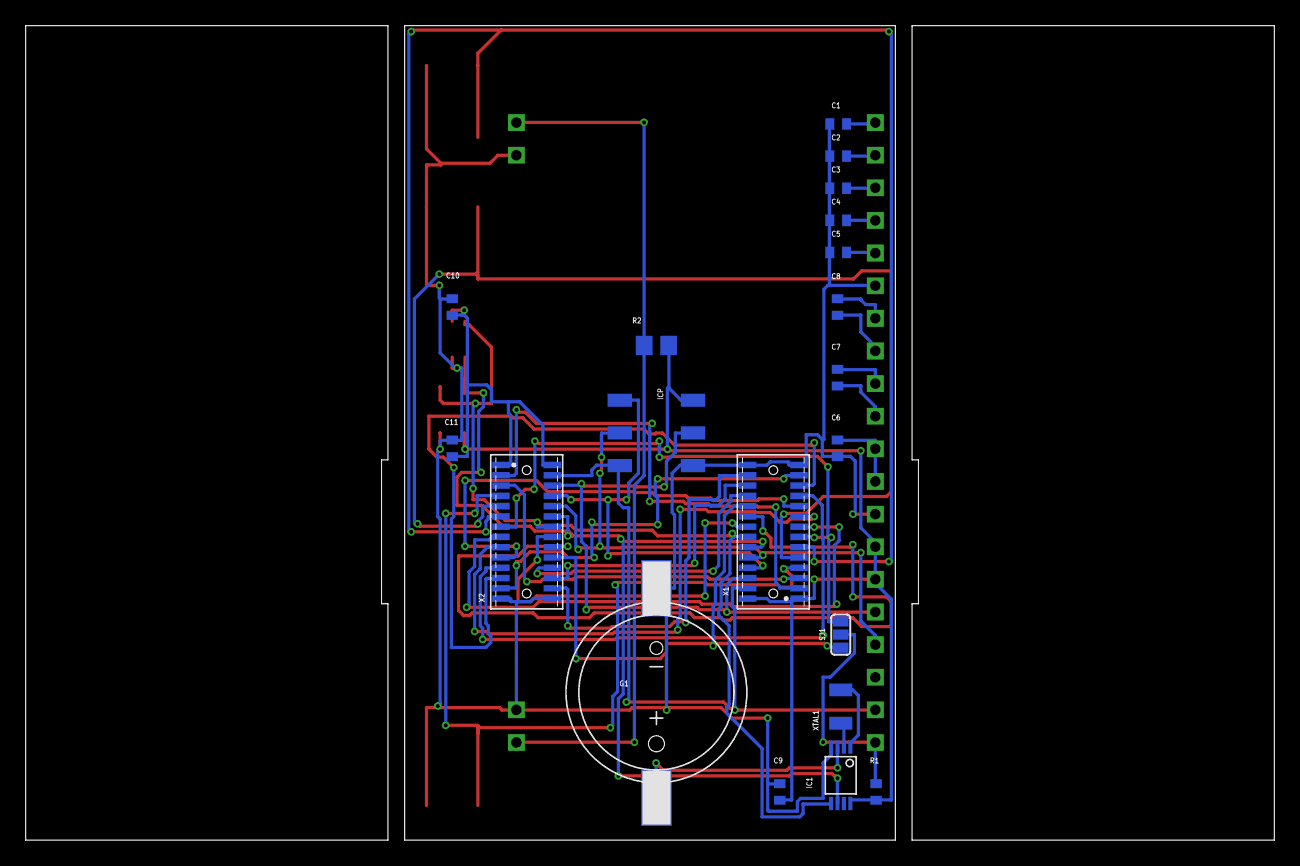
[picture p19: board Smart ezNODE 503 M2.brd from below]

Board: 2 copper layers, 97.2 x 63.4 mm, 26 parts (20 on the bottom side), 41 nets.
