projectsatlab/SmartNODE503/Hardware/Eagle files/Smart ezNODE 503 M1.brd

## EAGLE design Hardware/Eagle files/Smart ezNODE 503 M1.brd (2016-12-12)

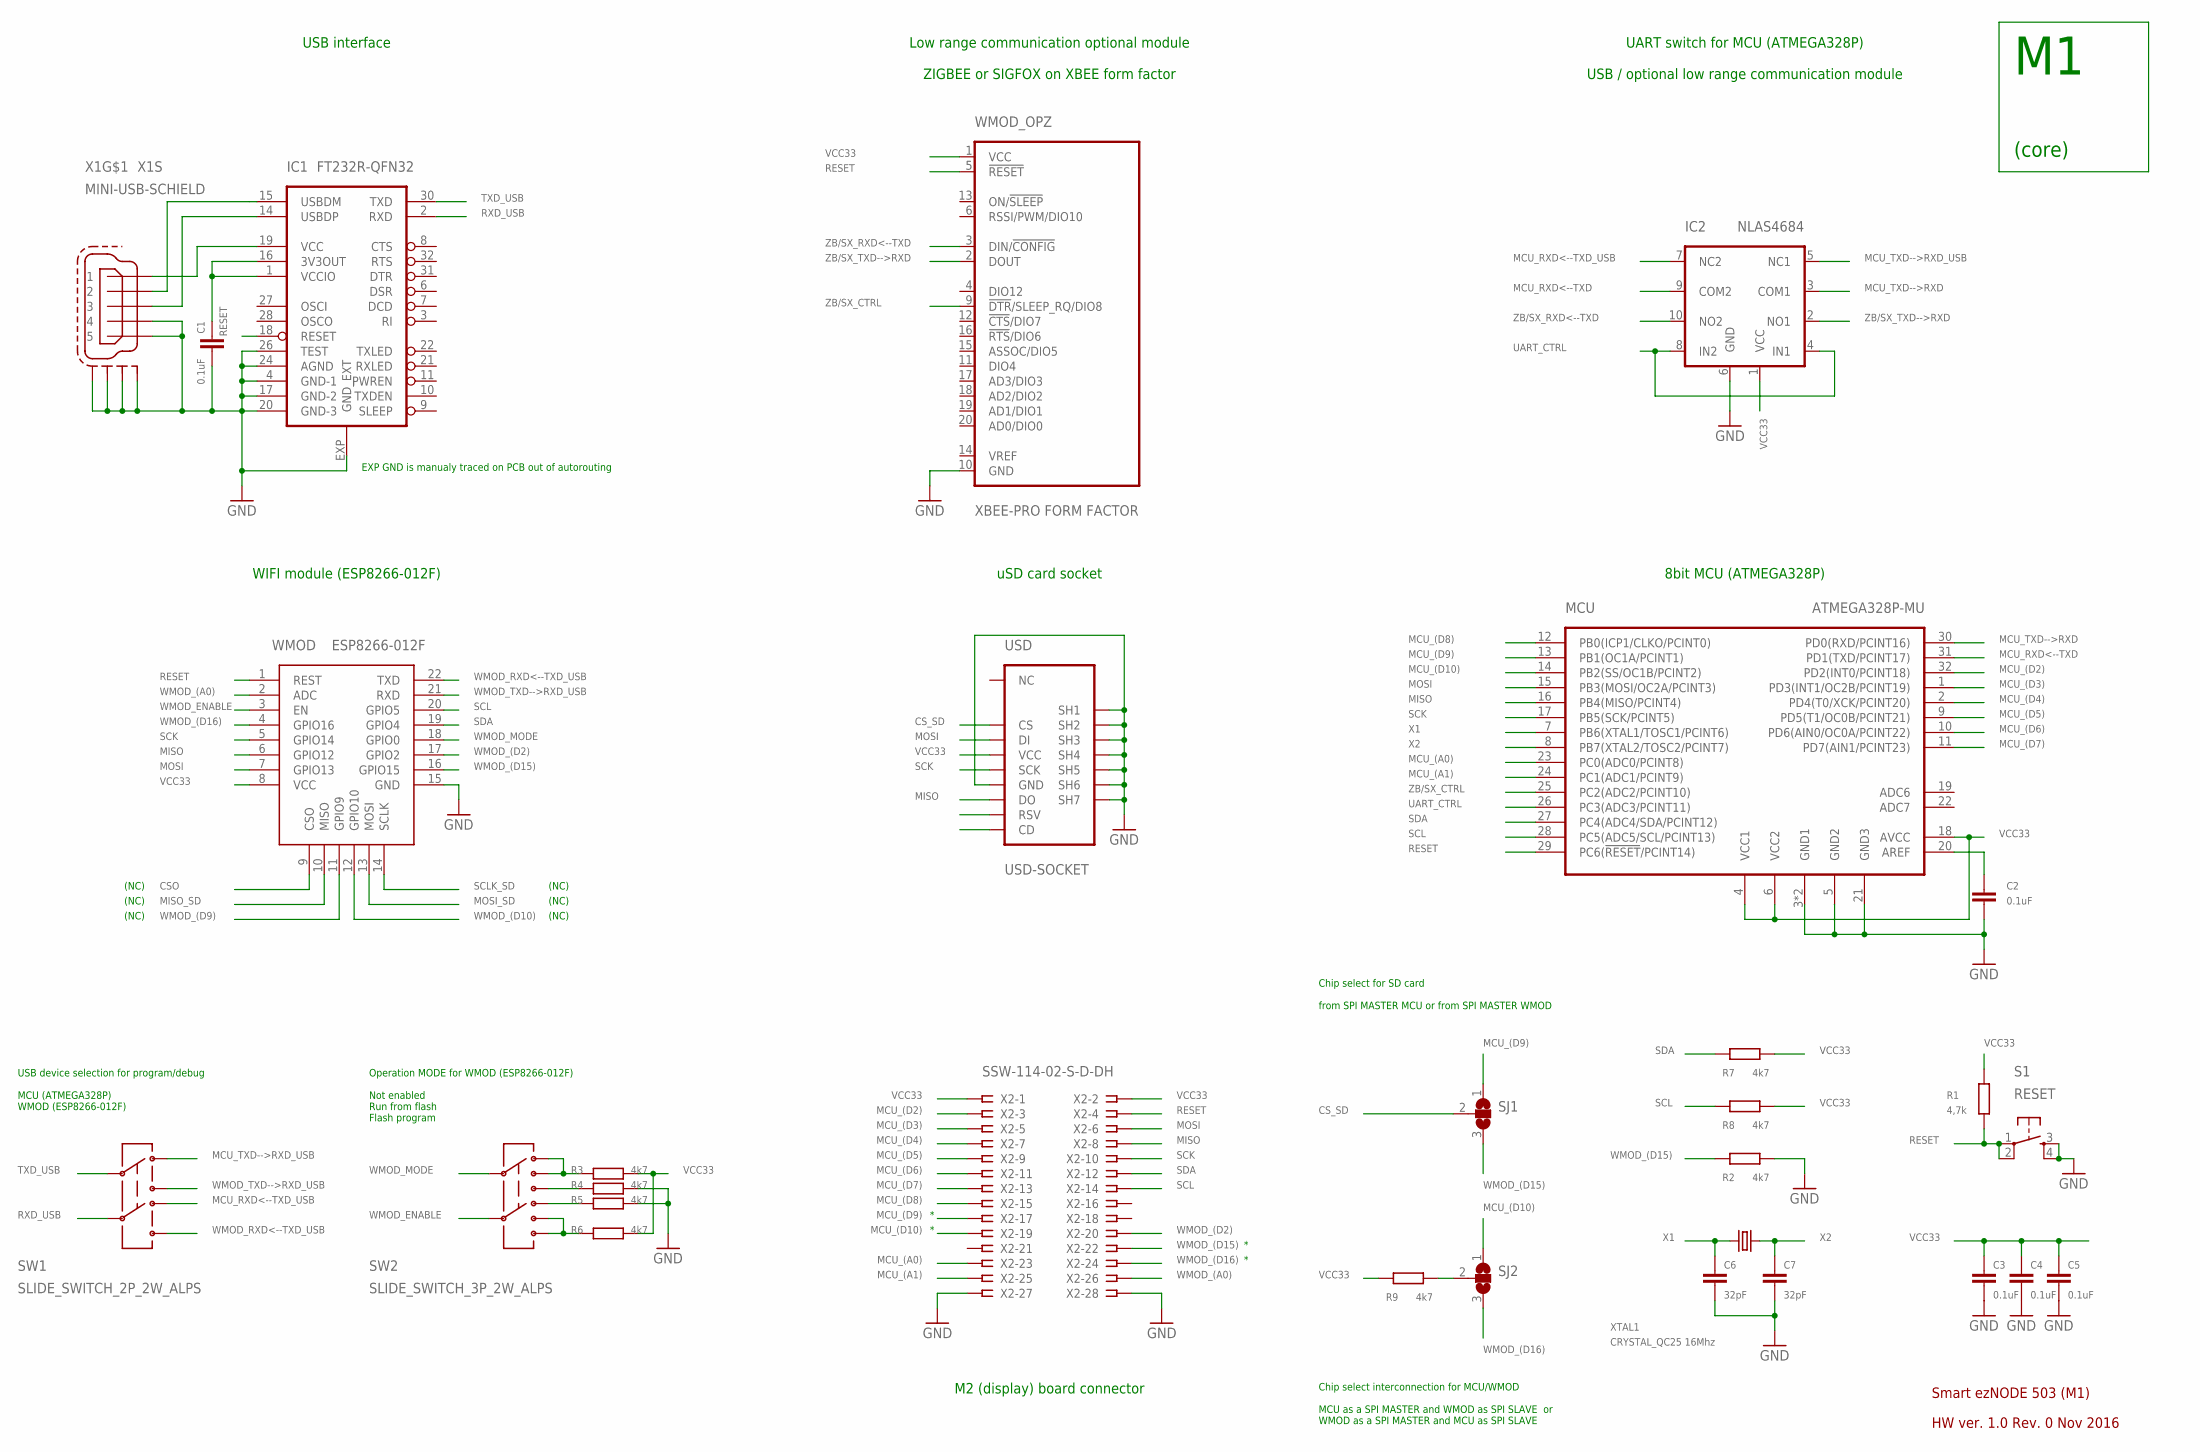
[picture p20: schematic Smart ezNODE 503 M1.sch]

Parts:
C1, C2, C3, C4, C5: 0.1uF; C0402
C6, C7: 32pF; C0201
IC1: FT232R-QFN32; QFN32
IC2: NLAS4684; MSOP10
MCU: ATMEGA328P-MU; MLF32
R1: 4,7k; R0402
R2, R3, R4, R5, R6, R7, R8, R9: 4k7; R0402
S1: RESET; C&K_KMS
SJ1, SJ2: SJ2W; SJ_2
SW1: SLIDE_SWITCH_2P_2W_ALPS; SLIDE_SWITCH_ALPS_SSSS820201
SW2: SLIDE_SWITCH_3P_2W_ALPS; SLIDE_SWITCH_ALPS_SSSS820301
USD: USD-SOCKET; USD-SOCKET-PP
WMOD: ESP8266-012F; ESP8266-ESP12
WMOD_OPZ: XBEE-PRO FORM FACTOR; XBEE-PRO
X1: MINI-USB-SCHIELD; MOLEX_67503-X20
X2: SSW-114-02-S-D-DH; FTE-114-XX-G-DH
XTAL1: CRYSTAL_QC25 16Mhz; CRYSTAL_QC25

Connections:
CSO: WMOD.9 (CSO)
CS_SD: SJ1.2, USD.P$2 (CS)
D+: IC1.14 (USBDP), X1.3
D-: IC1.15 (USBDM), X1.2
GND: C1.2, C2.2, C3.2, C4.2, C5.2, C6.2, C7.2, IC1.4 (GND-1), IC1.17 (GND-2), IC1.20 (GND-3), IC1.24 (AGND), IC1.26 (TEST), IC1.EXP (GND_EXT), IC2.6 (GND), MCU.3 (GND1), MCU.5 (GND2), MCU.21 (GND3), MCU.TH (GND1), R2.2, R4.1, R5.1, S1.3, S1.4, USD.P$6 (GND), USD.P$9 (SH1), USD.P$10 (SH2), USD.P$12 (SH3), USD.P$13 (SH4), USD.P$14 (SH5), USD.P$15 (SH6), USD.P$16 (SH7), WMOD.15 (GND), WMOD_OPZ.10 (GND), X1.4, X1.5, X1.M1 (S1), X1.M2 (S2), X1.M3 (S3), X1.M4 (S4), X2.27, X2.28
MCU_(A0): MCU.23 (PC0(ADC0/PCINT8)), X2.23
MCU_(A1): MCU.24 (PC1(ADC1/PCINT9)), X2.25
MCU_(D2): MCU.32 (PD2(INT0/PCINT18)), X2.3
MCU_(D3): MCU.1 (PD3(INT1/OC2B/PCINT19)), X2.5
MCU_(D4): MCU.2 (PD4(T0/XCK/PCINT20)), X2.7
MCU_(D5): MCU.9 (PD5(T1/OC0B/PCINT21)), X2.9
MCU_(D6): MCU.10 (PD6(AIN0/OC0A/PCINT22)), X2.11
MCU_(D7): MCU.11 (PD7(AIN1/PCINT23)), X2.13
MCU_(D8): MCU.12 (PB0(ICP1/CLKO/PCINT0)), X2.15
MCU_(D9): MCU.13 (PB1(OC1A/PCINT1)), SJ1.1, X2.17
MCU_(D10): MCU.14 (PB2(SS/OC1B/PCINT2)), SJ2.1, X2.19
MCU_RXD<--TXD: IC2.9 (COM2), MCU.31 (PD1(TXD/PCINT17))
MCU_RXD<--TXD_USB: IC2.7 (NC2), SW1.4
MCU_TXD-->RXD: IC2.3 (COM1), MCU.30 (PD0(RXD/PCINT16))
MCU_TXD-->RXD_USB: IC2.5 (NC1), SW1.1
MISO: MCU.16 (PB4(MISO/PCINT4)), USD.P$7 (DO), WMOD.6 (GPIO12), X2.8
MISO_SD: WMOD.10 (MISO)
MOSI: MCU.15 (PB3(MOSI/OC2A/PCINT3)), USD.P$3 (DI), WMOD.7 (GPIO13), X2.6
MOSI_SD: WMOD.13 (MOSI)
unnamed: R9.2, SJ2.2
unnamed: C1.1, IC1.1 (VCCIO), IC1.16 (3V3OUT)
unnamed: R6.2, SW2.6, SW2.8
unnamed: C2.1, MCU.20 (AREF)
unnamed: R3.2, SW2.1, SW2.2
unnamed: R4.2, SW2.4
unnamed: R5.2, SW2.5
RESET: IC1.18 (RESET), MCU.29 (PC6(!RESET!/PCINT14)), R1.1, S1.1, S1.2, WMOD.1 (REST), WMOD_OPZ.5 (!RESET), X2.4
RXD_USB: IC1.2 (RXD), SW1.5
SCK: MCU.17 (PB5(SCK/PCINT5)), USD.P$5 (SCK), WMOD.5 (GPIO14), X2.10
SCL: MCU.28 (PC5(ADC5/SCL/PCINT13)), R8.1, WMOD.20 (GPIO5), X2.14
SCLK_SD: WMOD.14 (SCLK)
SDA: MCU.27 (PC4(ADC4/SDA/PCINT12)), R7.1, WMOD.19 (GPIO4), X2.12
TXD_USB: IC1.30 (TXD), SW1.2
UART_CTRL: IC2.4 (IN1), IC2.8 (IN2), MCU.26 (PC3(ADC3/PCINT11))
VBUS: IC1.19 (VCC), X1.1
VCC33: C3.1, C4.1, C5.1, IC2.1 (VCC), MCU.4 (VCC1), MCU.6 (VCC2), MCU.18 (AVCC), R1.2, R3.1, R6.1, R7.2, R8.2, R9.1, USD.P$4 (VCC), WMOD.8 (VCC), WMOD_OPZ.1 (VCC), X2.1, X2.2
WMOD_(A0): WMOD.2 (ADC), X2.26
WMOD_(D2): WMOD.17 (GPIO2), X2.20
WMOD_(D9): WMOD.11 (GPIO9)
WMOD_(D10): WMOD.12 (GPIO10)
WMOD_(D15): R2.1, SJ1.3, WMOD.16 (GPIO15), X2.22
WMOD_(D16): SJ2.3, WMOD.4 (GPIO16), X2.24
WMOD_ENABLE: SW2.7, WMOD.3 (EN)
WMOD_MODE: SW2.3, WMOD.18 (GPIO0)
WMOD_RXD<--TXD_USB: SW1.6, WMOD.22 (TXD)
WMOD_TXD-->RXD_USB: SW1.3, WMOD.21 (RXD)
X1: C6.1, MCU.7 (PB6(XTAL1/TOSC1/PCINT6)), XTAL1.P$1 (1)
X2: C7.1, MCU.8 (PB7(XTAL2/TOSC2/PCINT7)), XTAL1.P$3 (3)
ZB/SX_CTRL: MCU.25 (PC2(ADC2/PCINT10)), WMOD_OPZ.9 (!DTR!/SLEEP_RQ/DIO8)
ZB/SX_RXD<--TXD: IC2.10 (NO2), WMOD_OPZ.3 (DIN/!CONFIG)
ZB/SX_TXD-->RXD: IC2.2 (NO1), WMOD_OPZ.2 (DOUT)

Notes on the sheet:
Smart ezNODE 503 (M1)
HW ver. 1.0 Rev. 0 Nov 2016
(core)
Chip select for SD card from SPI MASTER MCU or from SPI MASTER WMOD
Chip select interconnection for MCU/WMOD MCU as a SPI MASTER and WMOD as SPI SLAVE or WMOD as a SPI MASTER and MCU as SPI SLAVE
USB device selection for program/debug MCU (ATMEGA328P) WMOD (ESP8266-012F)
Operation MODE for WMOD (ESP8266-012F) Not enabled Run from flash Flash program
Low range communication optional module ZIGBEE or SIGFOX on XBEE form factor
USB interface
UART switch for MCU (ATMEGA328P) USB / optional low range communication module
WIFI module (ESP8266-012F)
uSD card socket
8bit MCU (ATMEGA328P)
M2 (display) board connector
(NC)
EXP GND is manualy traced on PCB out of autorouting

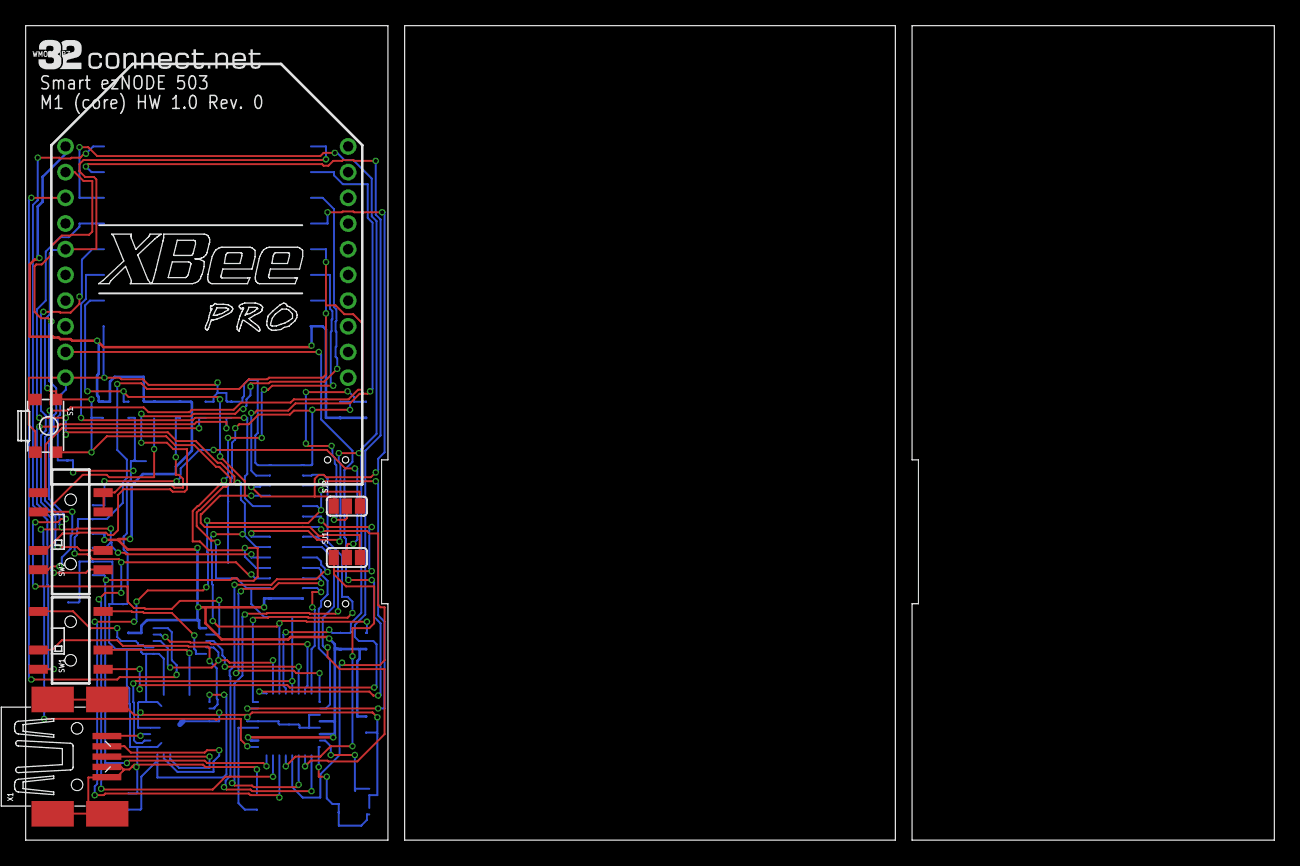
[picture p21: board Smart ezNODE 503 M1.brd from above]

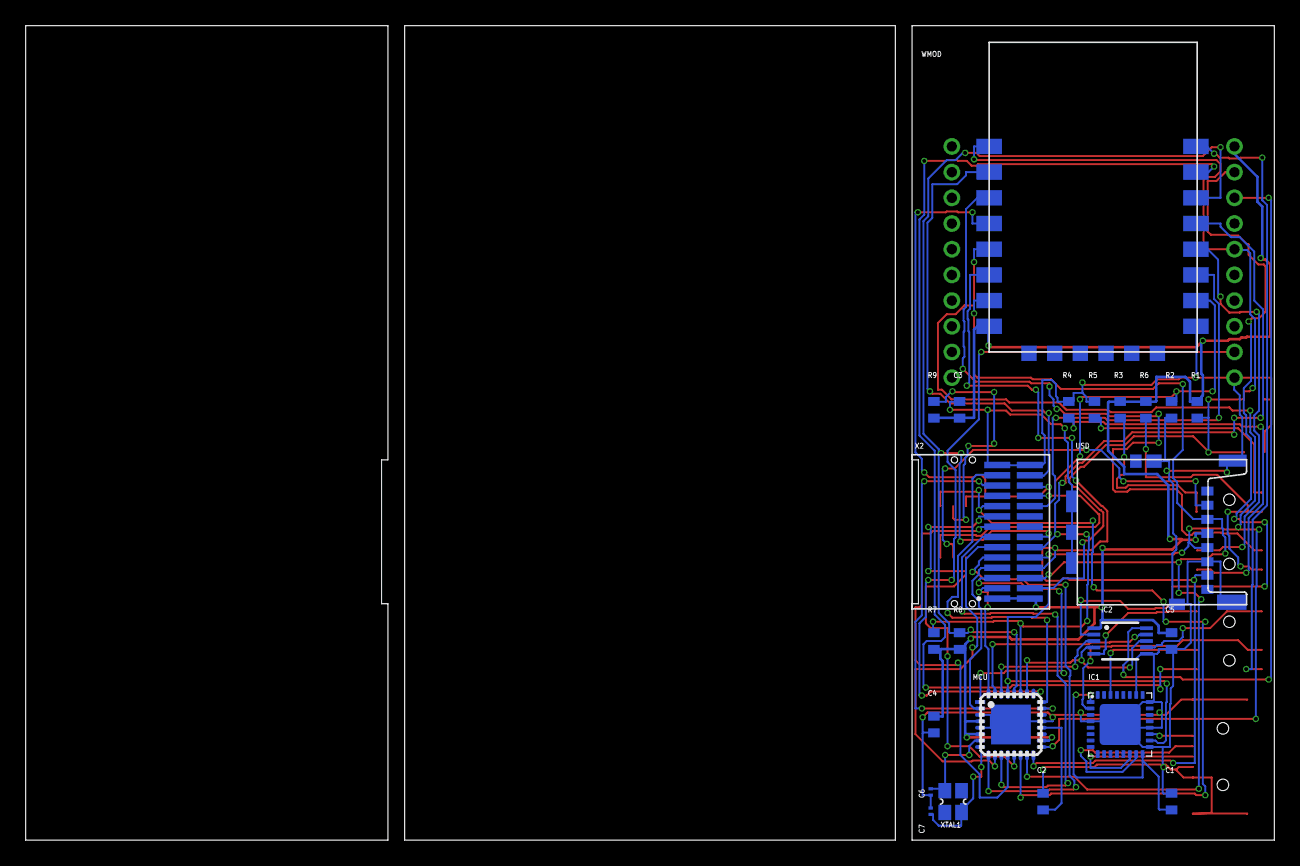
[picture p22: board Smart ezNODE 503 M1.brd from below]

Board: 2 copper layers, 97.2 x 63.4 mm, 30 parts (23 on the bottom side), 50 nets.
