projectsatlab/SmartNODE503/Hardware/Eagle files/Smart ezNODE 503 guide lines.brd

## EAGLE design Hardware/Eagle files/Smart ezNODE 503 guide lines.brd (2016-12-11)

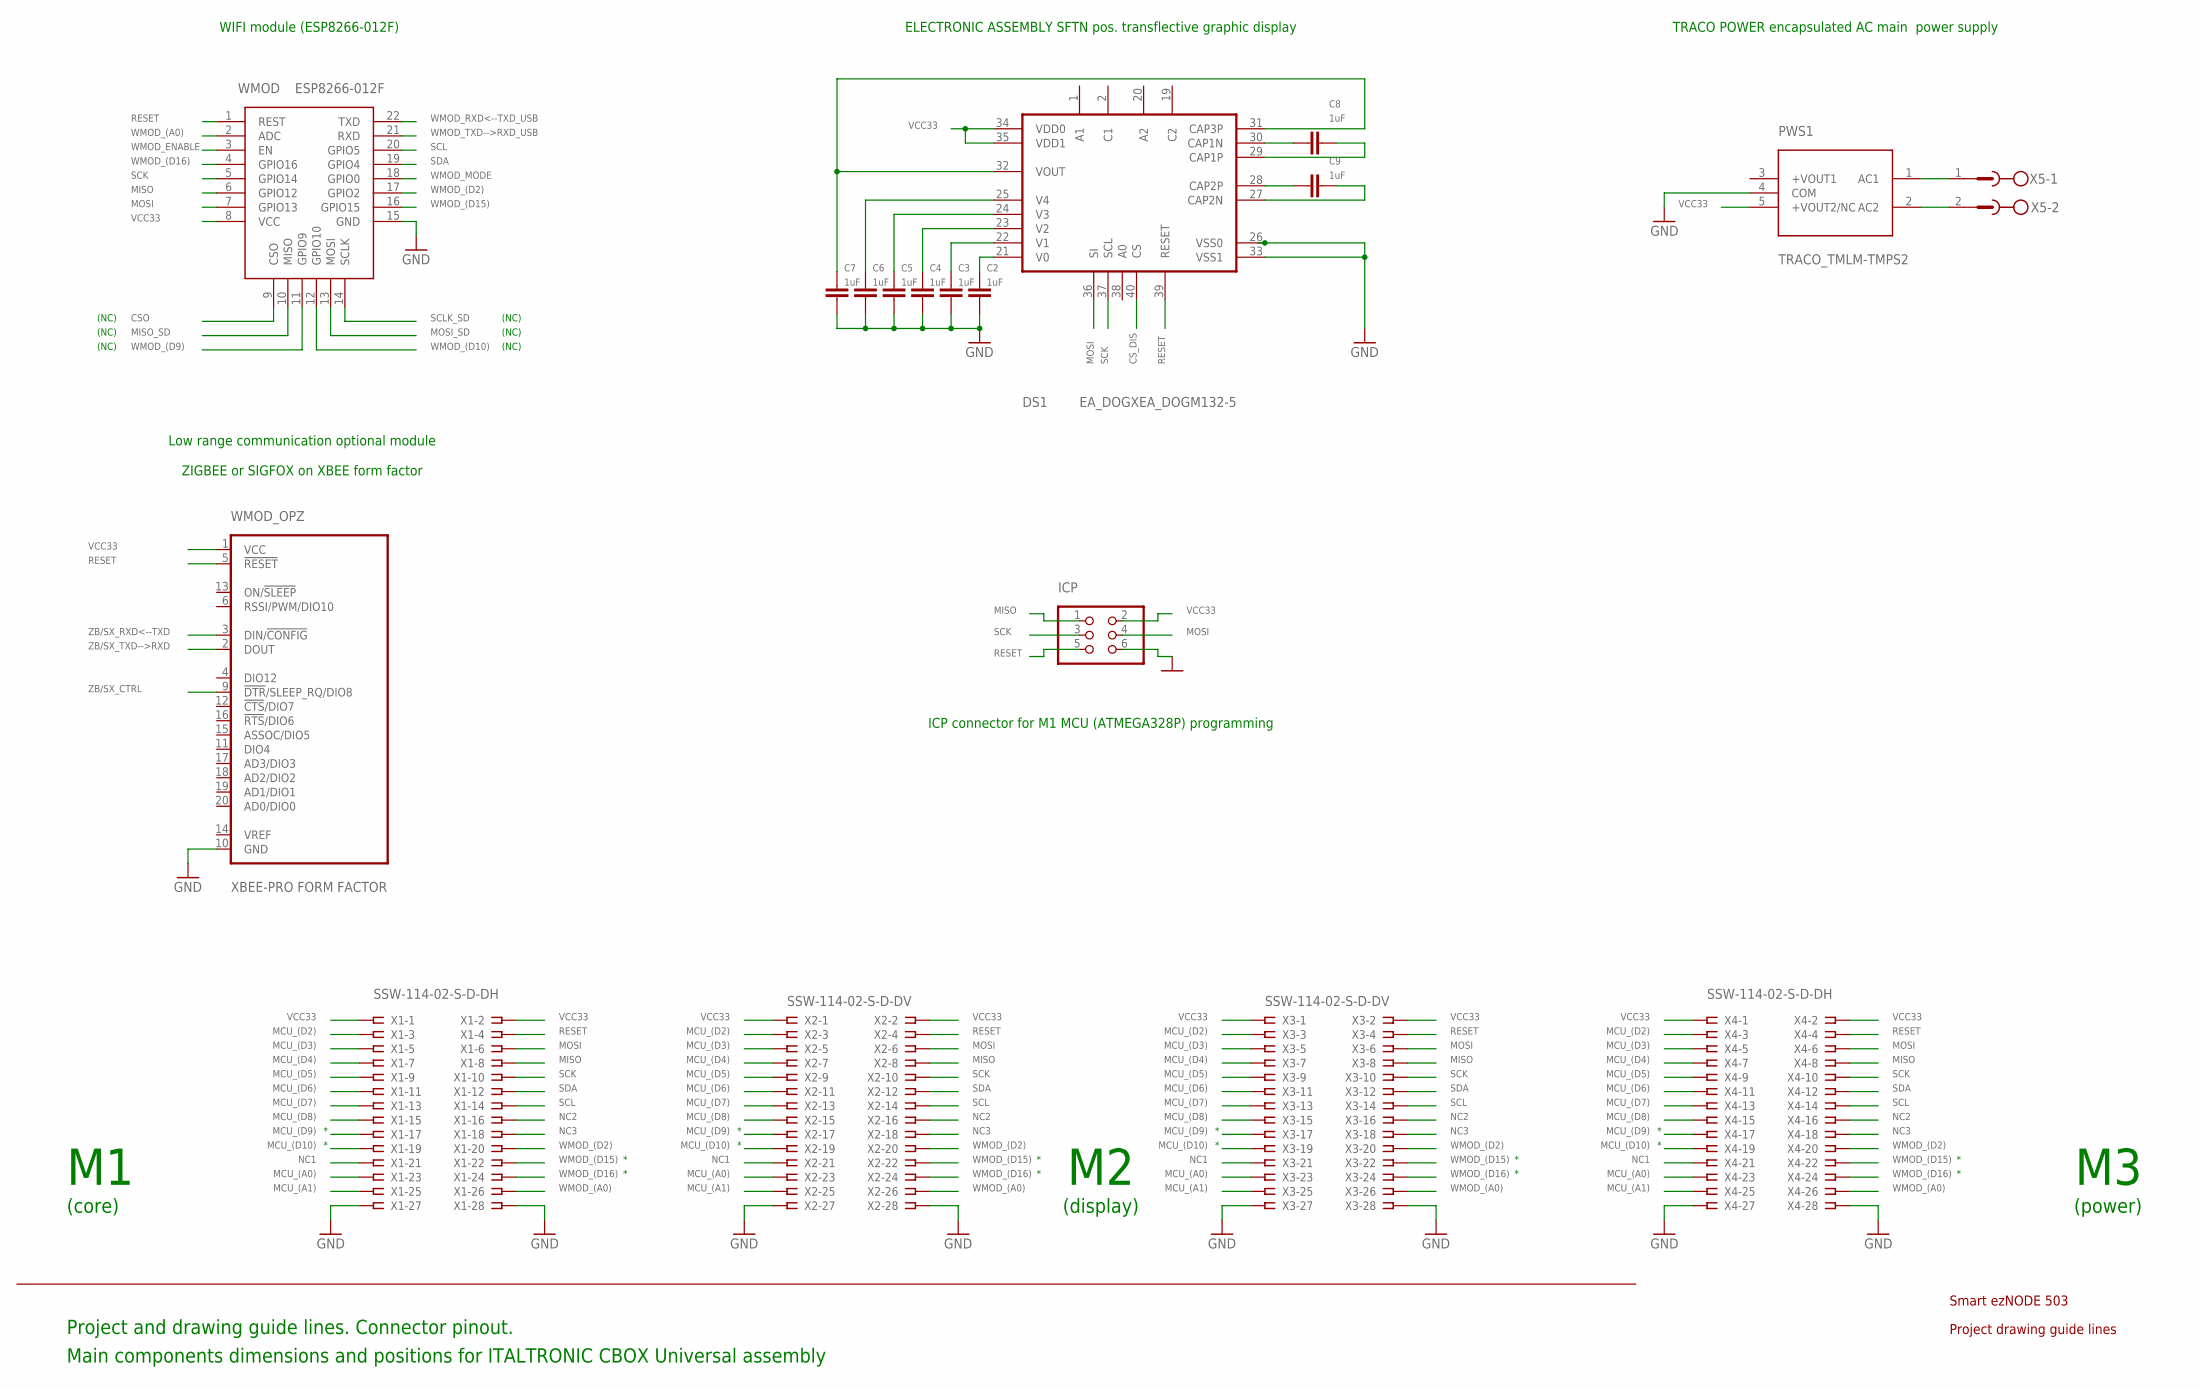
[picture p23: schematic Smart ezNODE 503 guide lines.sch]

Parts:
C2, C3, C4, C5, C6, C7, C8, C9: 1uF; C0402
DS1: EA_DOGXEA_DOGM132-5; EA_DOGM
ICP: PINHD-2X3/SMD; 2X3_SMD
PWS1: TRACO_TMLM-TMPS2; TRACO_TMPS03XXX
WMOD: ESP8266-012F; ESP8266-ESP12
WMOD_OPZ: XBEE-PRO FORM FACTOR; XBEE-PRO
X1, X4: SSW-114-02-S-D-DH; FTE-114-XX-G-DH
X2, X3: SSW-114-02-S-D-DV; CLE-114-01-X-DV-A
X5: MSTBV2

Connections:
CSO: WMOD.9 (CSO)
CS_DIS: DS1.40 (CS)
GND: C2.2, C3.2, C4.2, C5.2, C6.2, C7.2, DS1.26 (VSS0), DS1.33 (VSS1), ICP.6, PWS1.4 (COM), WMOD.15 (GND), WMOD_OPZ.10 (GND), X1.27, X1.28, X2.27, X2.28, X3.27, X3.28, X4.27, X4.28
MCU_(A0): X1.23, X2.23, X3.23, X4.23
MCU_(A1): X1.25, X2.25, X3.25, X4.25
MCU_(D2): X1.3, X2.3, X3.3, X4.3
MCU_(D3): X1.5, X2.5, X3.5, X4.5
MCU_(D4): X1.7, X2.7, X3.7, X4.7
MCU_(D5): X1.9, X2.9, X3.9, X4.9
MCU_(D6): X1.11, X2.11, X3.11, X4.11
MCU_(D7): X1.13, X2.13, X3.13, X4.13
MCU_(D8): X1.15, X2.15, X3.15, X4.15
MCU_(D9): X1.17, X2.17, X3.17, X4.17
MCU_(D10): X1.19, X2.19, X3.19, X4.19
MISO: ICP.1, WMOD.6 (GPIO12), X1.8, X2.8, X3.8, X4.8
MISO_SD: WMOD.10 (MISO)
MOSI: DS1.36 (SI), ICP.4, WMOD.7 (GPIO13), X1.6, X2.6, X3.6, X4.6
MOSI_SD: WMOD.13 (MOSI)
unnamed: PWS1.1 (AC1), X5.1
unnamed: PWS1.2 (AC2), X5.2
unnamed: C2.1, DS1.21 (V0)
unnamed: C8.1, DS1.30 (CAP1N)
unnamed: C3.1, DS1.22 (V1)
unnamed: C4.1, DS1.23 (V2)
unnamed: C5.1, DS1.24 (V3)
unnamed: C6.1, DS1.25 (V4)
unnamed: C7.1, DS1.31 (CAP3P), DS1.32 (VOUT)
unnamed: C8.2, DS1.29 (CAP1P)
unnamed: C9.1, DS1.28 (CAP2P)
unnamed: C9.2, DS1.27 (CAP2N)
NC1: X1.21, X2.21, X3.21, X4.21
NC2: X1.16, X2.16, X3.16, X4.16
NC3: X1.18, X2.18, X3.18, X4.18
RESET: DS1.39 (RESET), ICP.5, WMOD.1 (REST), WMOD_OPZ.5 (!RESET), X1.4, X2.4, X3.4, X4.4
SCK: DS1.37 (SCL), ICP.3, WMOD.5 (GPIO14), X1.10, X2.10, X3.10, X4.10
SCL: WMOD.20 (GPIO5), X1.14, X2.14, X3.14, X4.14
SCLK_SD: WMOD.14 (SCLK)
SDA: WMOD.19 (GPIO4), X1.12, X2.12, X3.12, X4.12
VCC33: DS1.34 (VDD0), DS1.35 (VDD1), ICP.2, WMOD.8 (VCC), WMOD_OPZ.1 (VCC), X1.1, X1.2, X2.1, X2.2, X3.1, X3.2, X4.1, X4.2
WMOD_(A0): WMOD.2 (ADC), X1.26, X2.26, X3.26, X4.26
WMOD_(D2): WMOD.17 (GPIO2), X1.20, X2.20, X3.20, X4.20
WMOD_(D9): WMOD.11 (GPIO9)
WMOD_(D10): WMOD.12 (GPIO10)
WMOD_(D15): WMOD.16 (GPIO15), X1.22, X2.22, X3.22, X4.22
WMOD_(D16): WMOD.4 (GPIO16), X1.24, X2.24, X3.24, X4.24
WMOD_ENABLE: WMOD.3 (EN)
WMOD_MODE: WMOD.18 (GPIO0)
WMOD_RXD<--TXD_USB: WMOD.22 (TXD)
WMOD_TXD-->RXD_USB: WMOD.21 (RXD)
ZB/SX_RXD<--TXD: WMOD_OPZ.3 (DIN/!CONFIG)
ZB/SX_TXD-->RXD: WMOD_OPZ.2 (DOUT)

Notes on the sheet:
WIFI module (ESP8266-012F)
Low range communication optional module ZIGBEE or SIGFOX on XBEE form factor
Smart ezNODE 503
Project drawing guide lines
(core)
(display)
(power)
Project and drawing guide lines. Connector pinout.
Main components dimensions and positions for ITALTRONIC CBOX Universal assembly
ELECTRONIC ASSEMBLY SFTN pos. transflective graphic display
TRACO POWER encapsulated AC main power supply
ICP connector for M1 MCU (ATMEGA328P) programming
(NC)

Board: 2 copper layers, 18 parts (16 on the bottom side), 38 nets, no tracks yet.
