projectsatlab/SmartNODE503/(notices)

Notices in the files:
parts and their libraries:
sensirion: Copyright (C) 2011, Bob Starr
SparkFun-Aesthetics: Licensing: Creative Commons ShareAlike 4.0 International - https://creativecommons.org/licenses/by-sa/4.0
